FITYYDS/ne301/Script/docs/NE301_PRODUCT_CAPABILITY_OVERVIEW.md

# NE301 产品能力总图

## 1. 一句话理解

NE301 不是“一个能拍照的 AI 摄像头”这么简单，它本质上是一套把感知、联网、视频、AI、运维和升级能力，统一收敛到同一套 MCU 服务框架里的产品平台。

## 2. NE301 产品能力总图

```text
                                         +--------------------------------+
                                         |          NE301 产品能力        |
                                         +---------------+----------------+
                                                         |
                  +--------------------------------------+--------------------------------------+
                  |                                      |                                      |
                  v                                      v                                      v
       +------------------------+             +------------------------+             +------------------------+
       |     感知与触发域       |             |     连接与云协同域     |             |      视频与 AI 域      |
       +------------------------+             +------------------------+             +------------------------+
       | - 图片模式             |             | - WiFi / Cellular /    |             | - 本地实时预览         |
       | - 视频模式             |             |   PoE 多网络接入       |             | - WebSocket 视频输出   |
       | - PIR 触发             |             | - MQTT / MQTTS         |             | - RTMP / RTMPS 推流    |
       | - RTC 定时触发         |             | - 远程抓拍 / 远程休眠  |             | - 模型加载 / 重载      |
       | - 远程触发             |             | - 事件抓拍上报         |             | - 阈值调参             |
       | - 唤醒后快路径抓拍     |             | - 云端任务闭环         |             | - 单图验证 / 可视化    |
       +------------+-----------+             +------------+-----------+             +------------+-----------+
                    |                                      |                                      |
                    +----------------------+---------------+----------------------+---------------+
                                           |                                      |
                                           v                                      v
                              +------------+--------------------------------------+------------+
                              |                  设备与运维管理域                              |
                              +----------------------------------------------------------------+
                              | - 图像参数配置   - 灯光控制   - 存储管理   - 设备信息/设备名   |
                              | - 配置导入导出   - 日志导出   - 恢复出厂   - 系统重启          |
                              | - 固件版本查看   - 固件导出   - OTA 升级   - A/B 分区容错      |
                              +-------------------------------+--------------------------------+
                                                              |
                                                              v
                         +------------------------------------+------------------------------------+
                         |                     统一软件骨架                                  |
                         +-------------------------------------------------------------------+
                         | API 适配层: api_work_mode / api_network / api_mqtt / api_rtmp    |
                         |            api_ai / api_device / api_ota / api_preview            |
                         | Service 层: system_service / communication_service / mqtt_service  |
                         |            rtmp_service / ai_service / device_service / ota_service|
                         | Shared   : json_config_mgr / video_hub / service_init / NVS        |
                         +------------------------------------+--------------------------------+
                                                              |
              +-----------------------------------------------+-----------------------------------------------+
              |                                               |                                               |
              v                                               v                                               v
   +---------------------------+                  +---------------------------+                  +---------------------------+
   |       执行与驱动底座      |                  |       数据与存储底座      |                  |      整机架构底座         |
   +---------------------------+                  +---------------------------+                  +---------------------------+
   | - Camera / Encoder / AI   |                  | - Flash / OTA slots       |                  | - STM32N6 主控           |
   | - WiFi / 4G / PoE         |                  | - SD card / config        |                  | - U0 WakeCore            |
   | - Sensor / PIR / Light    |                  | - system_state / version  |                  | - 双 MCU 低功耗协同      |
   | - lwIP / Mongoose / HAL   |                  | - model package           |                  | - Web UI 本地管理入口    |
   +---------------------------+                  +---------------------------+                  +---------------------------+
```

## 3. 这张图怎么读

从上往下看：

1. 最上面是用户真正能感知到的产品能力。
2. 中间是这些能力共用的统一软件骨架，也就是 `api_xxx -> service_xxx -> config/persist -> HAL`。
3. 最下面是支撑这些能力的底座，包括视频链路、网络链路、存储链路，以及 `U0 + N6` 的双 MCU 架构。

从左往右看：

1. 左边偏“触发与控制”。
2. 中间偏“联网与云协同”。
3. 右边偏“视频与 AI 数据面”。
4. 下方单独汇总“设备运维与升级”。

## 4. 这张总图对应的核心判断

- NE301 的很多功能虽然在 wiki 上看起来是分散菜单，但在软件上并不是很多孤立模块，而是同一套服务框架的不同投影。
- `system_service` 是控制面中枢，`communication_service` 是网络中枢，`video_hub` 是视频数据分发中枢。
- 产品功能的扩展方式不是继续堆页面，而是往现有服务框架里接入新的策略、事件源和消费者。
