FITYYDS/ne301/Web/src/assets/images/camthink_Vision_AI_camera.webp

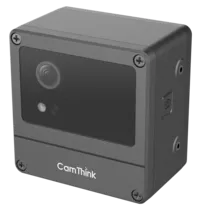
Web/src/assets/images/camthink_Vision_AI_camera.webp
