FITYYDS/ne301/Hardware/x3_top_cover.stp

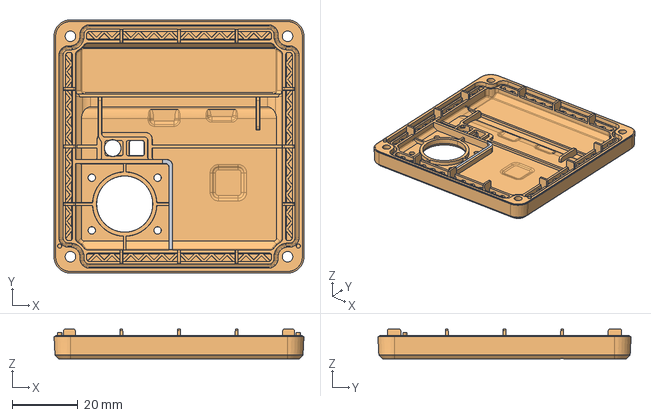
[picture p2: CAD file, 2026-01-15]
Hardware/x3_top_cover.stp
76.0 x 77.0 x 9.10 mm
