FITYYDS/ne301/Hardware/x3_d_cover.stp

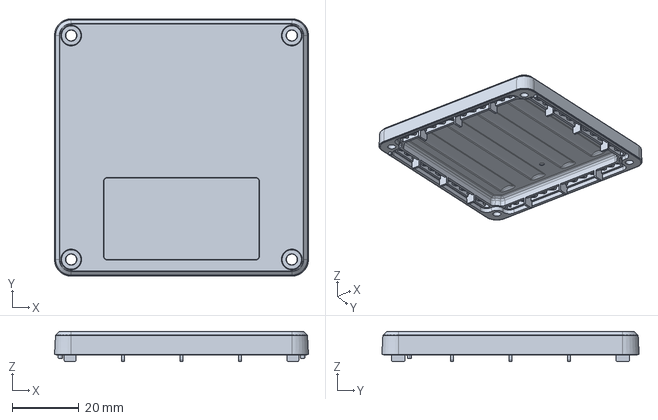
[picture p3: CAD file, 2026-01-15]
Hardware/x3_d_cover.stp
76.0 x 77.0 x 9.10 mm
