FITYYDS/ne301/Hardware/NE301_PCB.pdf

# ART FILM - SILKTOP

2025-10-21

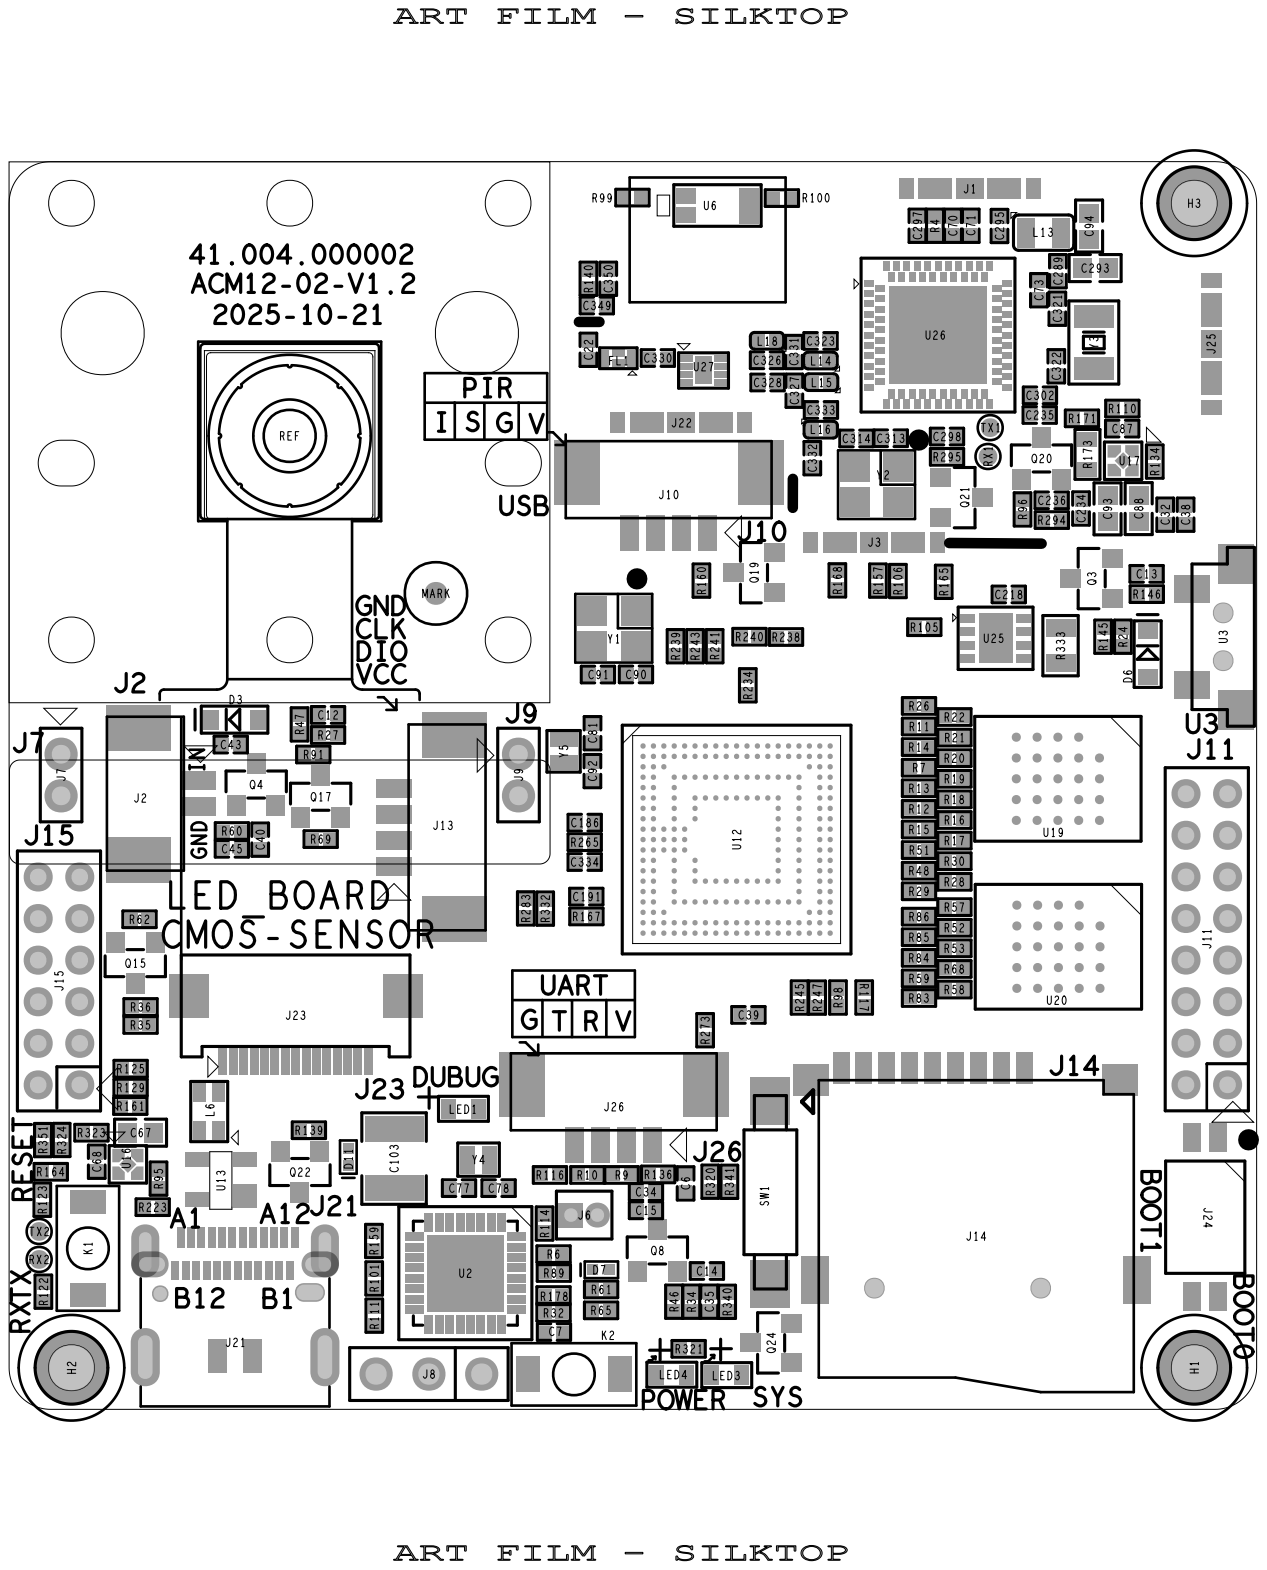
[picture p4: page 1]

R125 | J26
R129 R161 | | LED1

J8 | C7 | R321 LED4 LED3

# ART FILM - SILKBOT

# C239 R104 C69

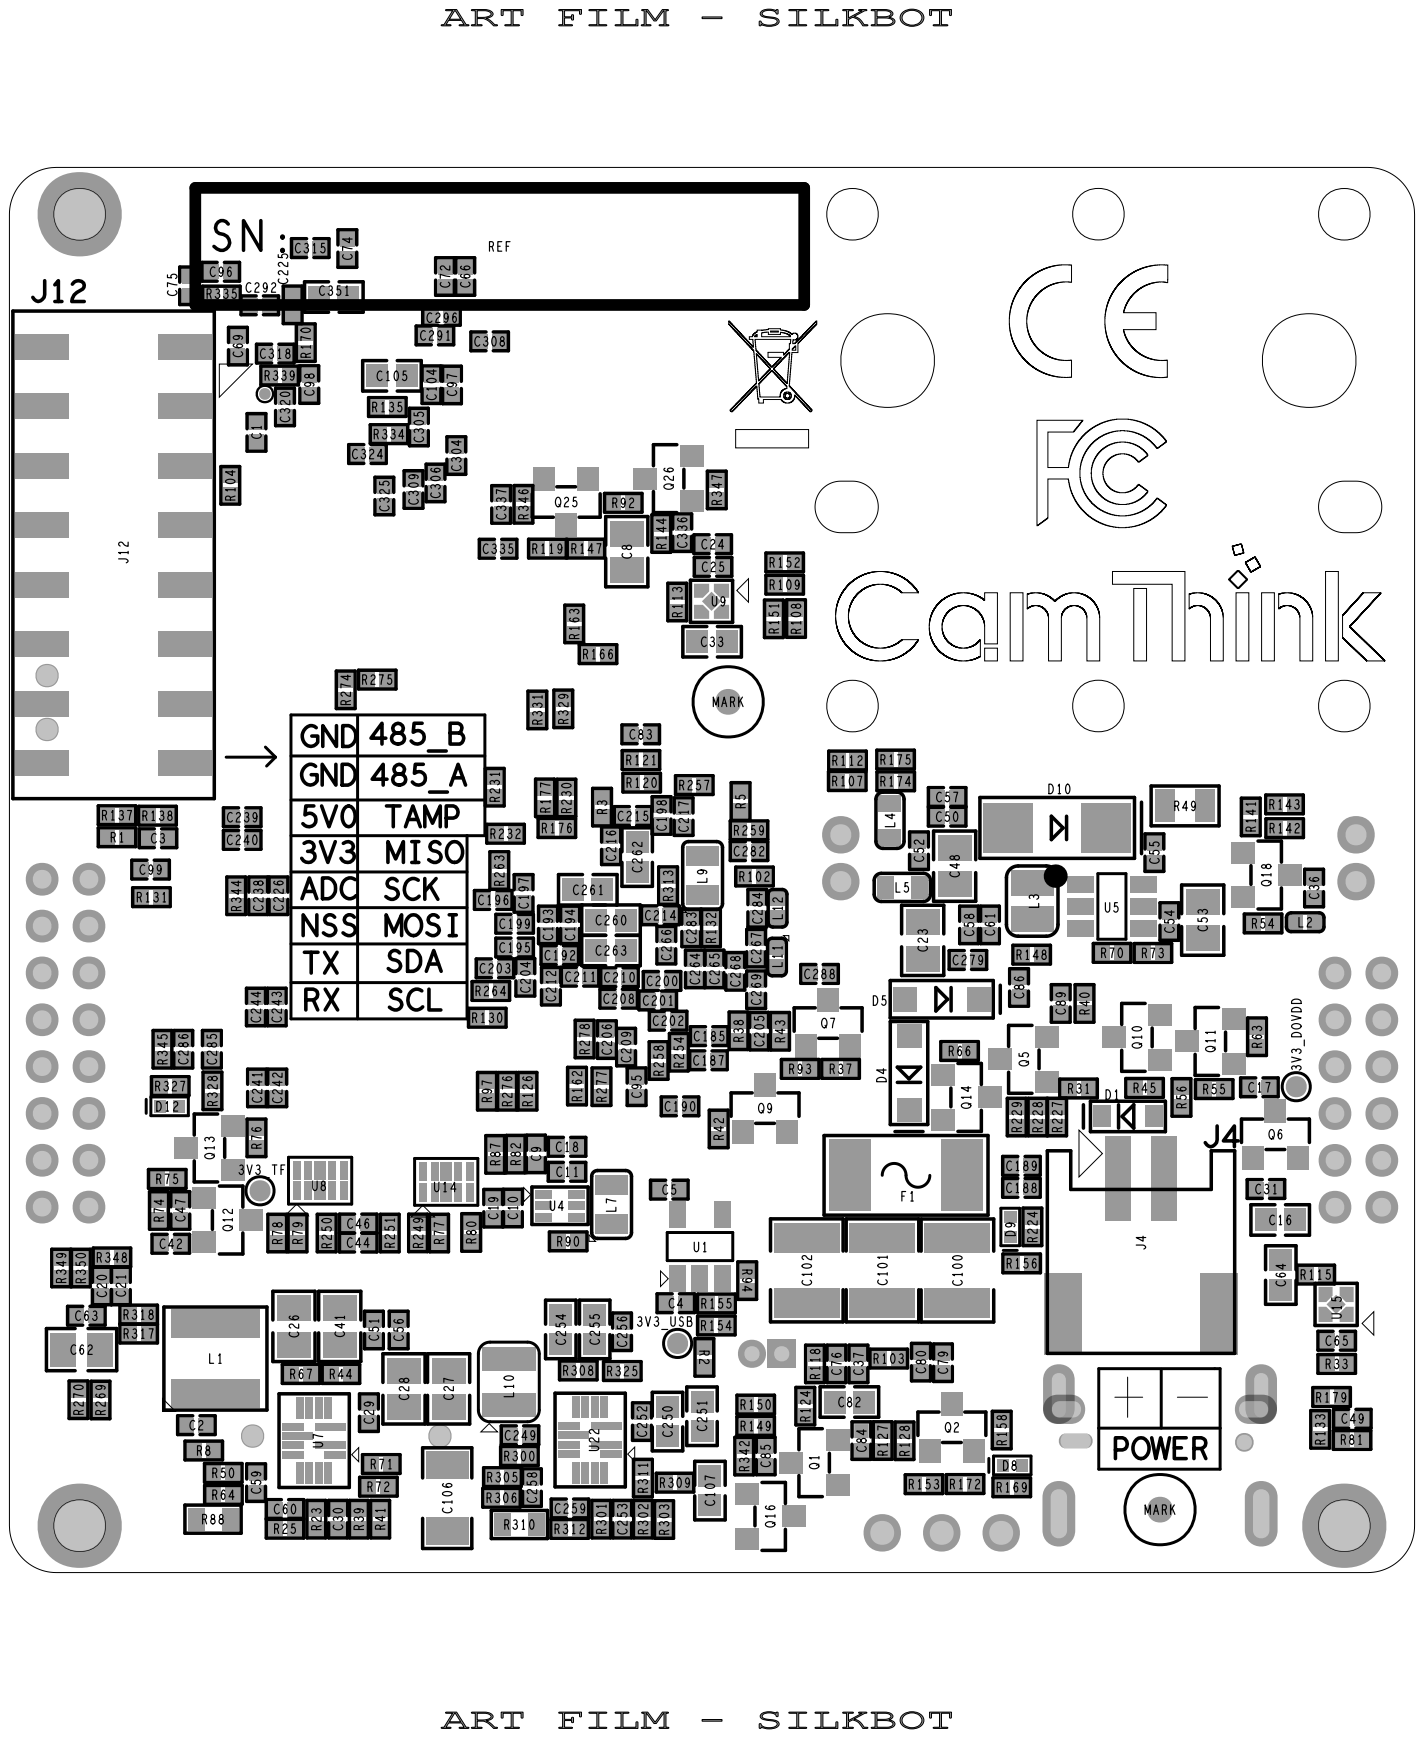
[picture p5: page 2]

5V0 3V3 | TAMP MISO | R232 R259 C282

NSS | MOSI
TX | SDA
