FITYYDS/ne301/Hardware/NE301_Schematic.pdf

D | D

# BLOCK DIAGRAM

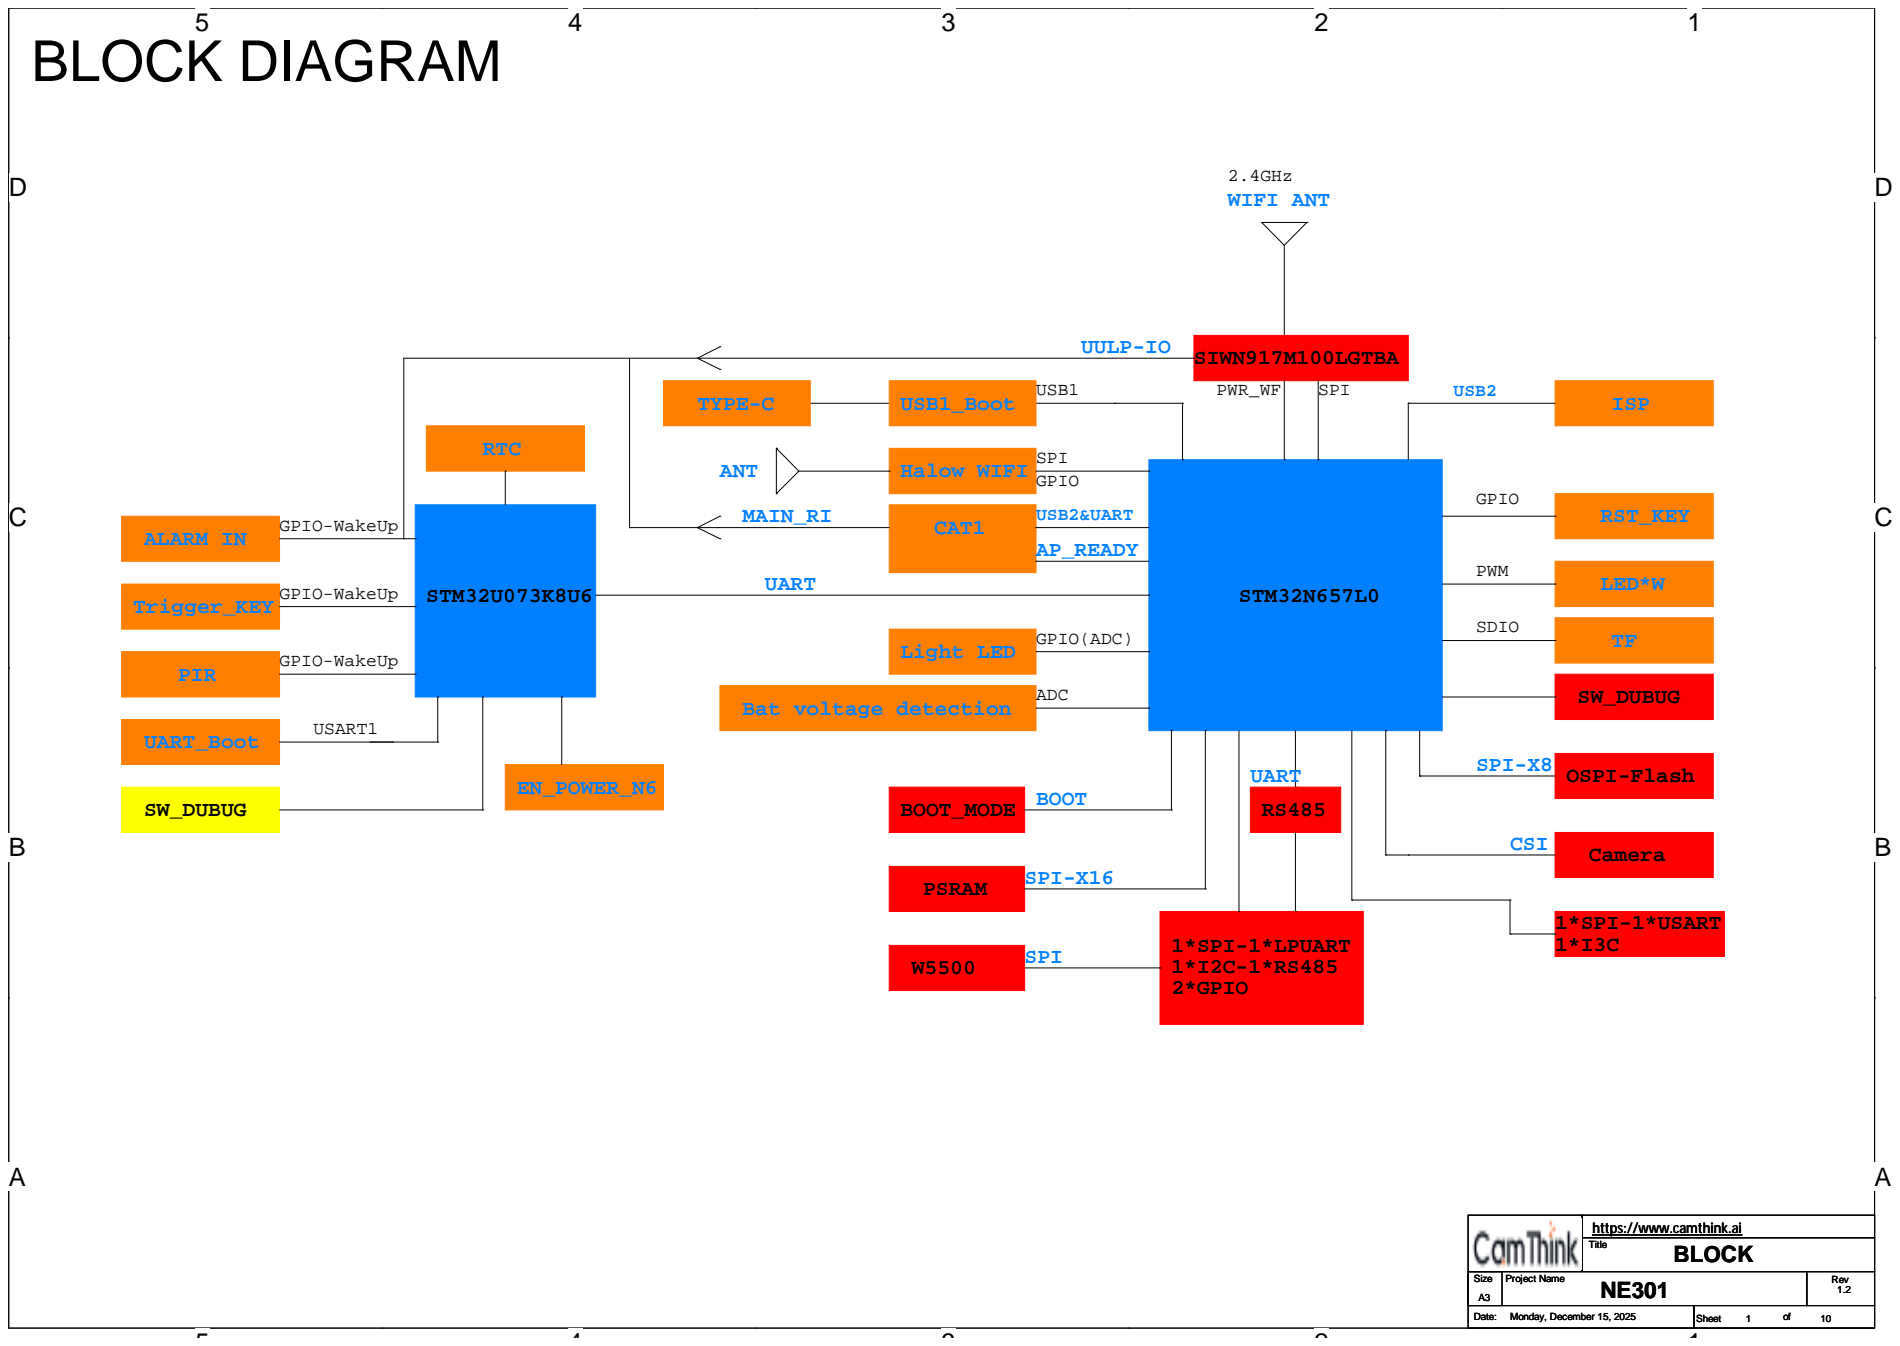
[picture p6: page 1]
Halow WIFI; ADC; TYPE-C; CAT1; 2.4GHz; GPIO(ADC); RST_KEY; GPIO; USB1_Boot; USB1; SW_DUBUG; WIFI ANT; ANT; STM32N657L0; SPI; USB2&UART; Light LED; PWM; LED*W; PSRAM; SPI-X16; Camera CSI; SDIO; PWR_WF; SIWN917M100LGTBA; ISP; USB2; 1*SPI-1*LPUART 1*I2C-1*RS485 2*GPIO; UART; BOOT_MODE; 1*SPI-1*USART 1*I3C; BOOT; STM32U073K8U6; GPIO-WakeUp; ALARM IN; Trigger_KEY; PIR; UART_Boot; USART1; RTC; UULP-IO; MAIN_RI; AP_READY; EN_POWER_N6; Size Project Name; Rev; Date:; Sheet; BLOCK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

Bat voltage detection

OSPI-Flash SPI-X8

https://www.camthink.ai
Title

# POWER TREE

## MP1462GD-Z

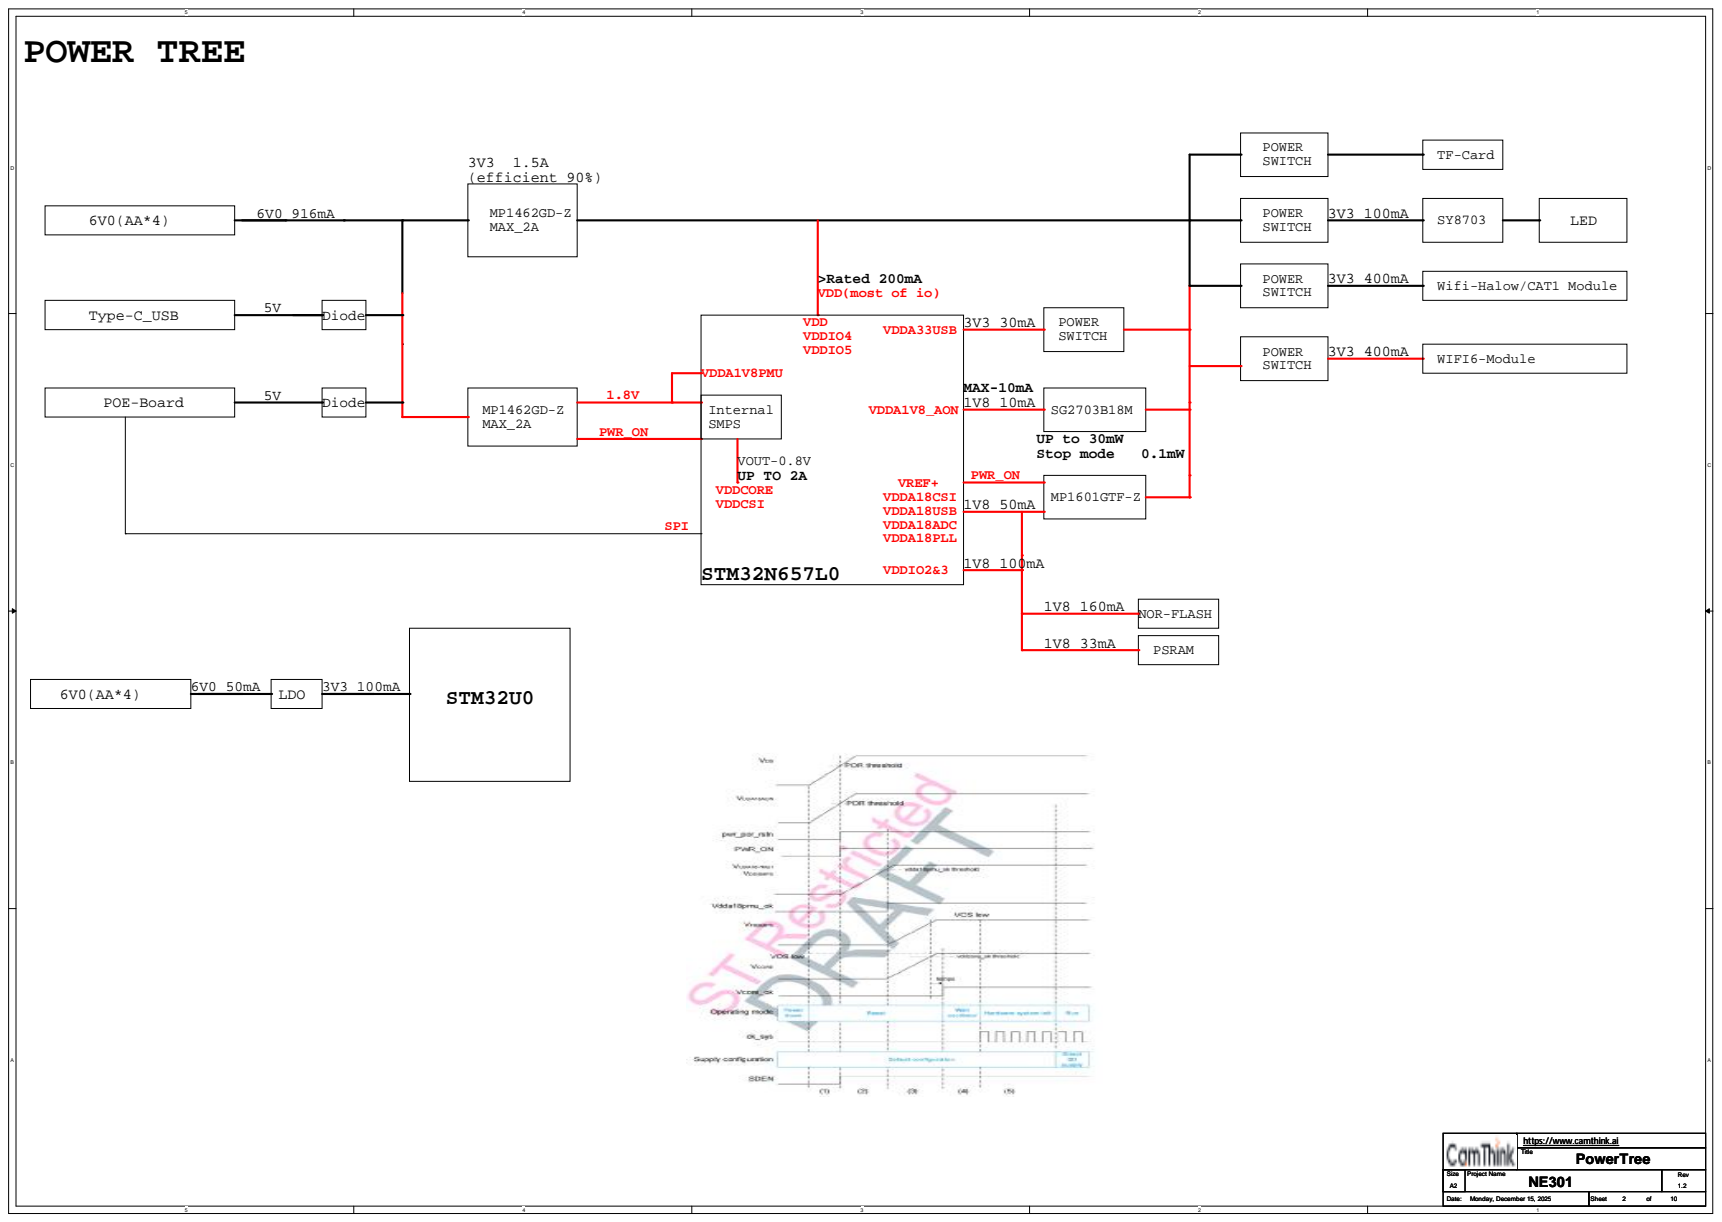
[picture p7: page 2]
MAX_2A 6V0(AA*4); 3V3 1.5A (efficient 90%); POWER SWITCH; LED 3V3 100mA; Type-C_USB; VDDA1V8_AON; STM32N657L0; VDDA33USB; VDDA18CSI VDDA18USB VDDA18ADC VDDA18PLL; VDD VDDIO4 VDDIO5; VREF+; PWR_ON; VDDCORE VDDCSI; POWER; SWITCH; TF-Card; WIFI6-Module; MAX-10mA; Stop mode; MP1462GD-Z MAX_2A; Internal SMPS; VOUT-0.8V; NOR-FLASH; PSRAM; POE-Board; SPI; VDDA1V8PMU; Diode; MP1601GTF-Z; VDDIO2&3 1V8 100mA; STM32U0 ⁶V0 50mA LDO 3V3 100mA; Title; PowerTree; Monday, December 15, 2025

>Rated 200mA
VDD(most of io)

Wifi-Halow/CAT1 Module 3V3 400mA

https://www.camthink.ai

# STM32N6

## STM32N657L0H3Q

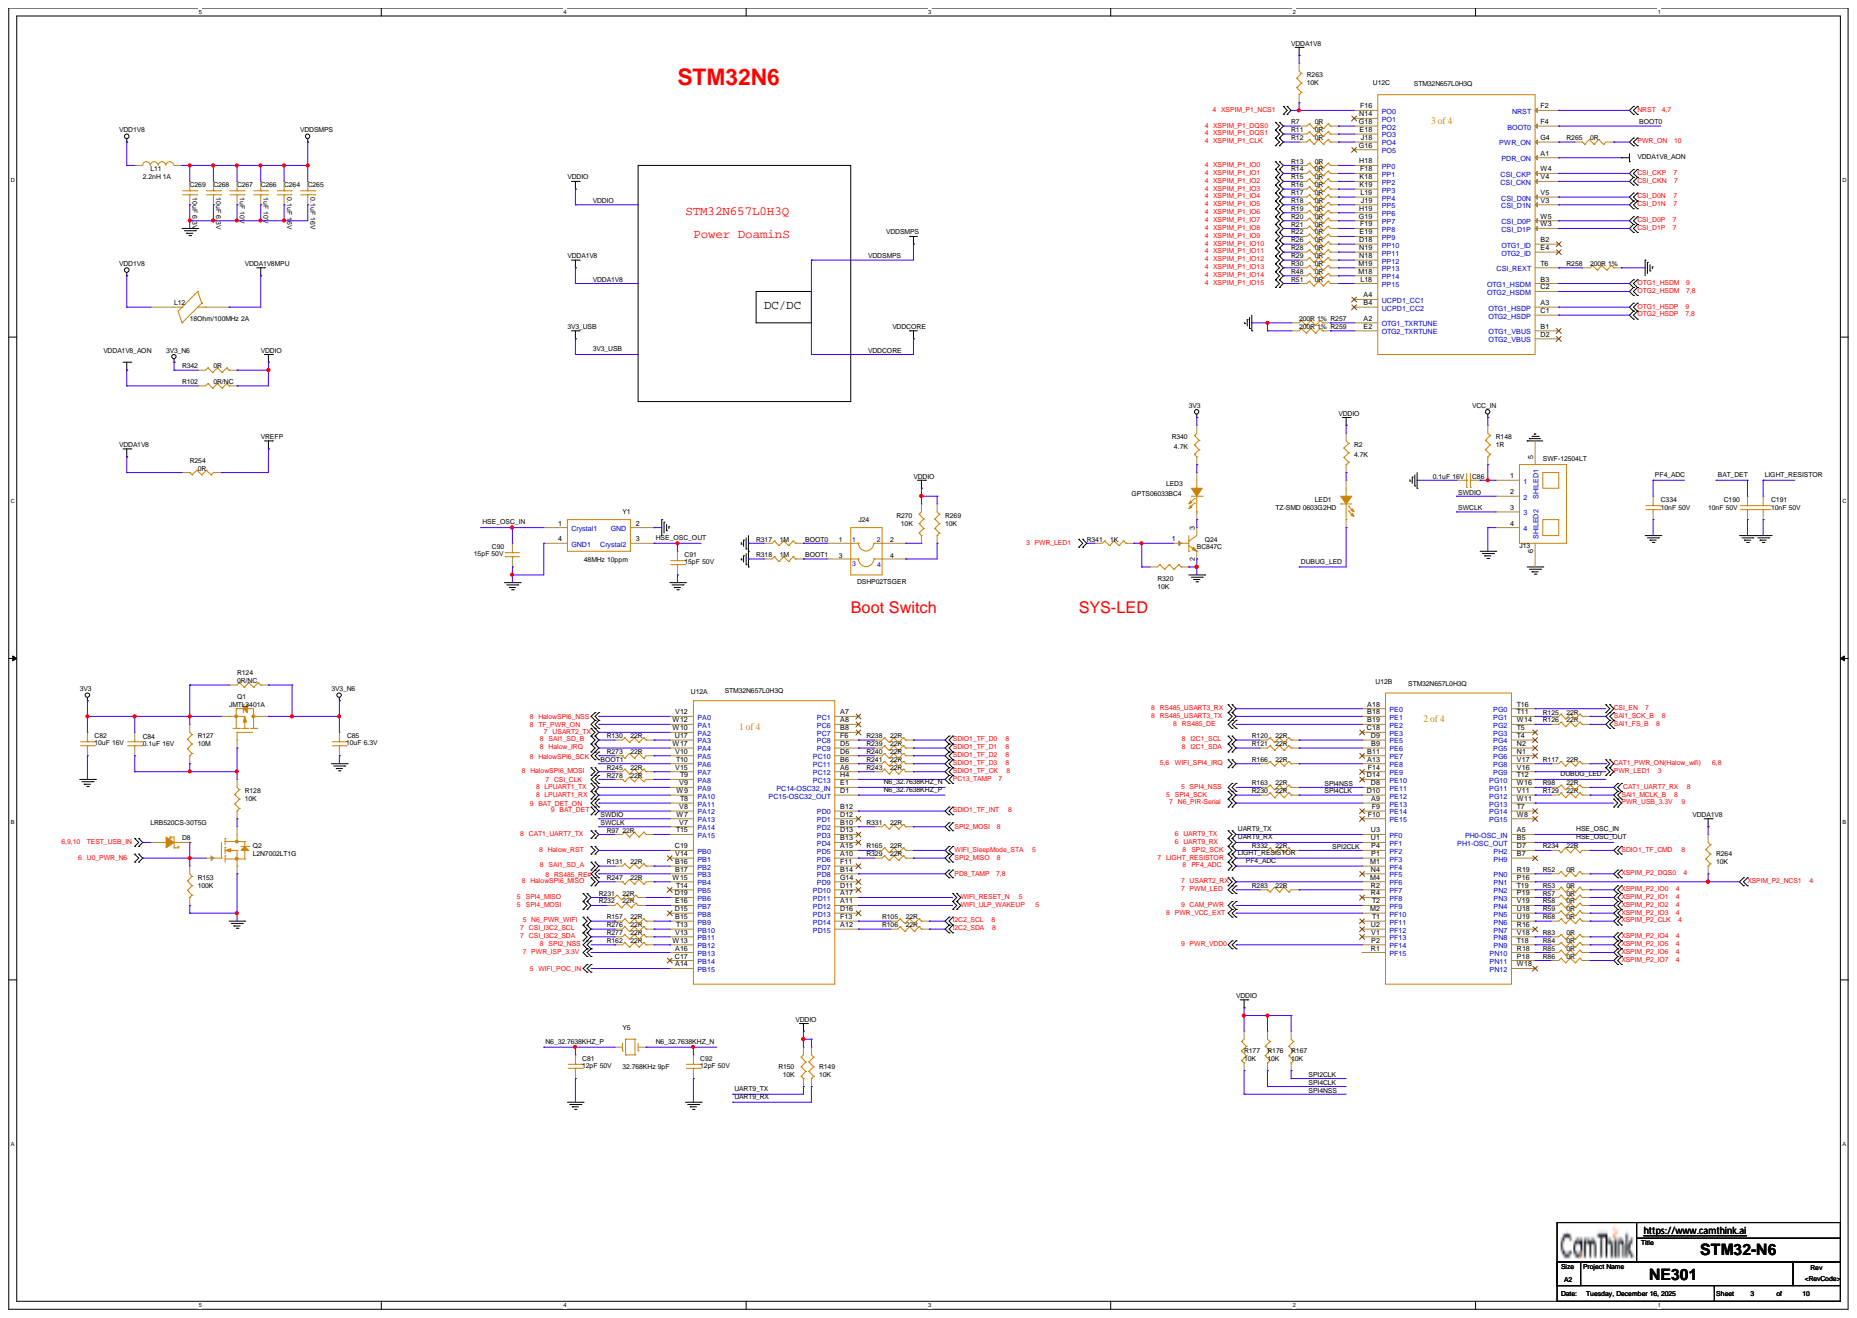
[picture p8: page 3]

https://www.camthink.ai

# PSRAM

## VDD_PSRAM

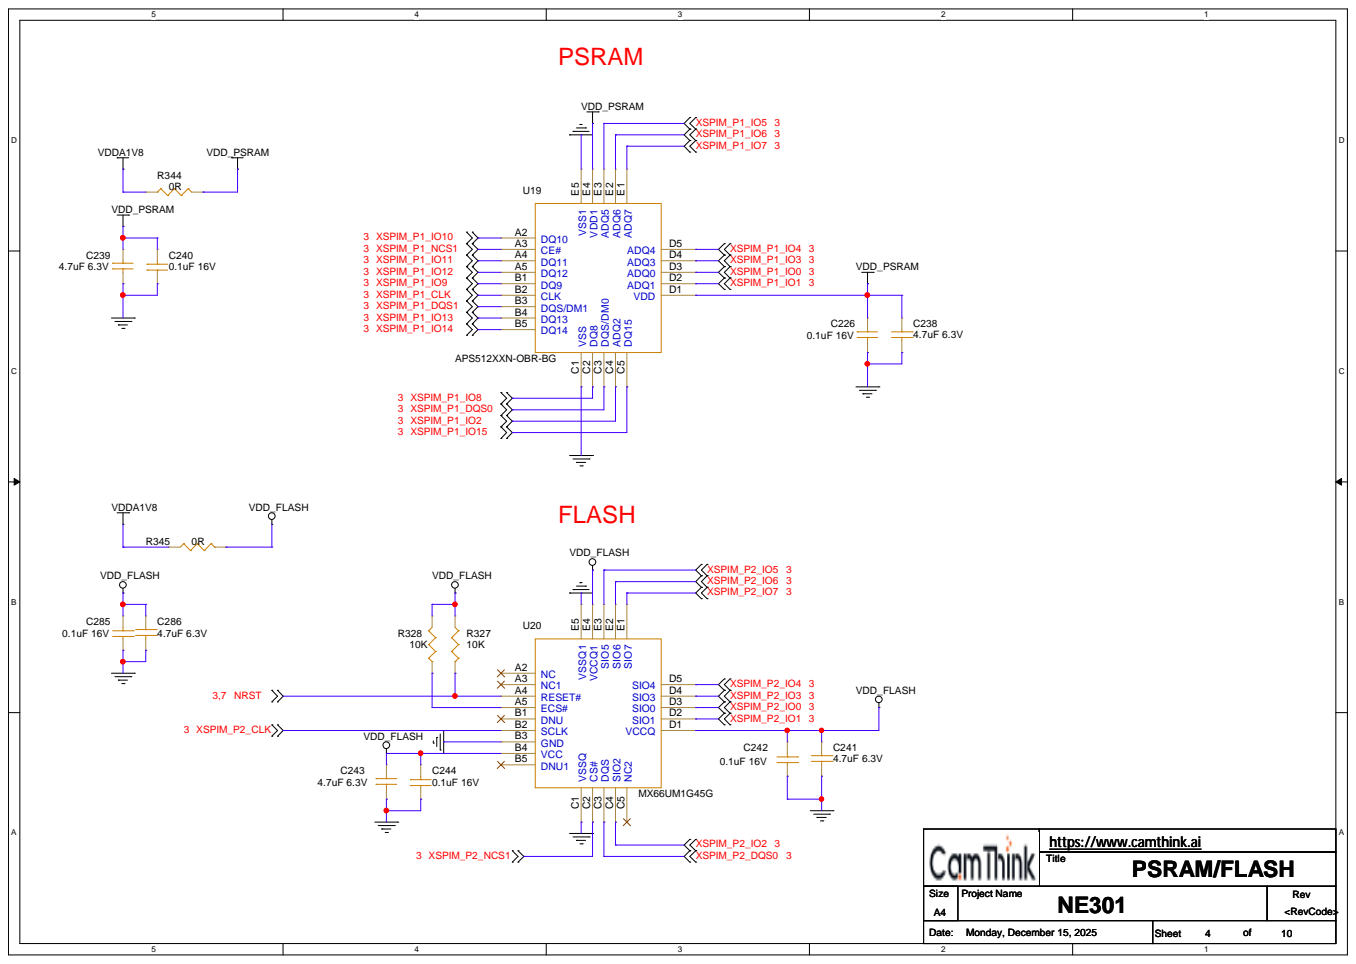
[picture p9: page 4]

## Power-IN

## 3V3_WIFI

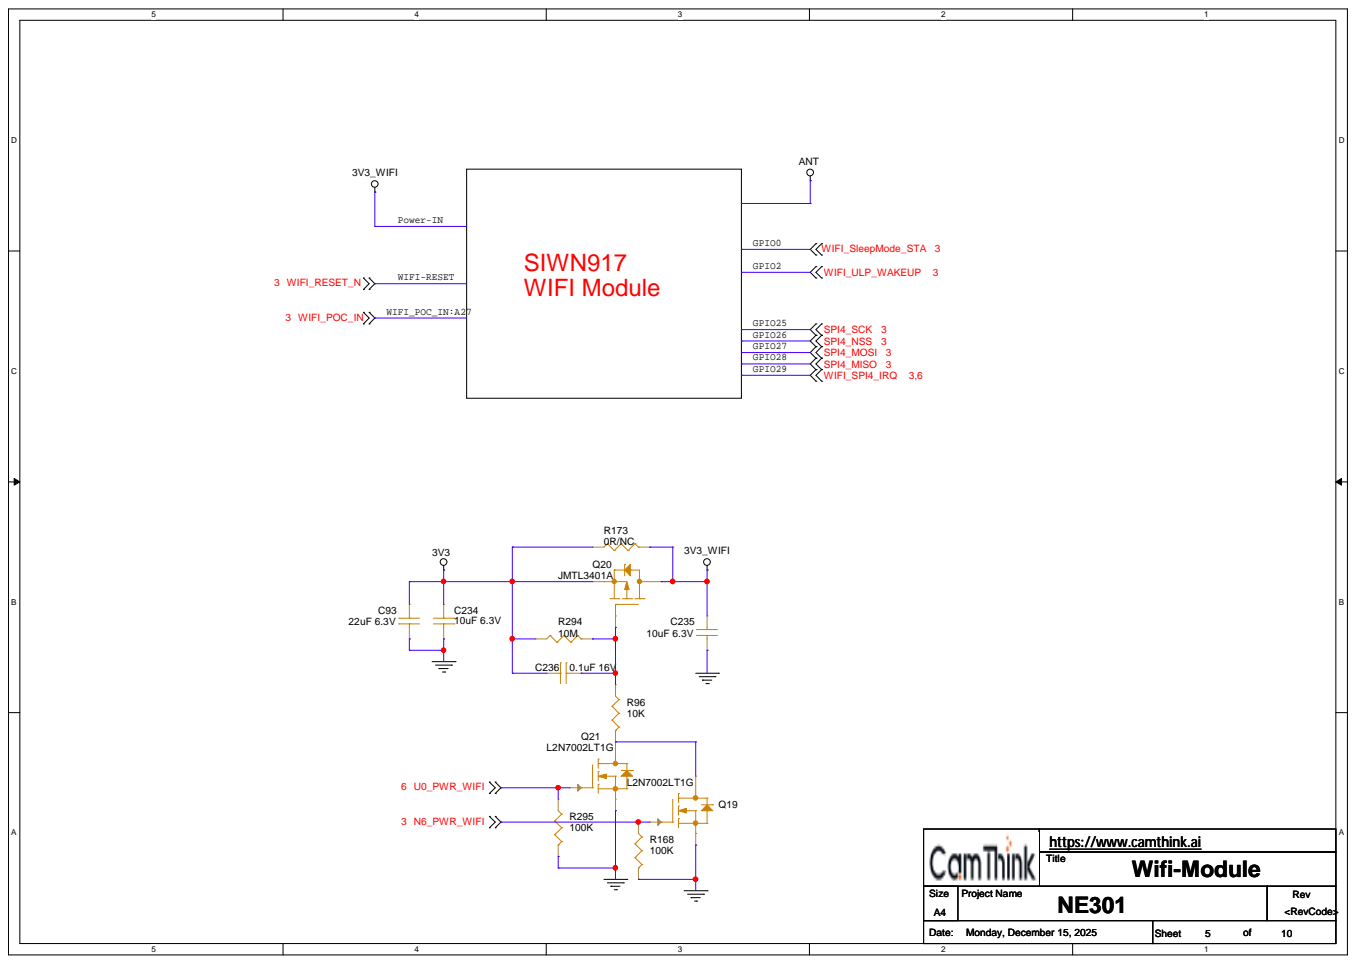
[picture p10: page 5]

https://www.camthink.ai

## 3V3_U0

## VCC_IN

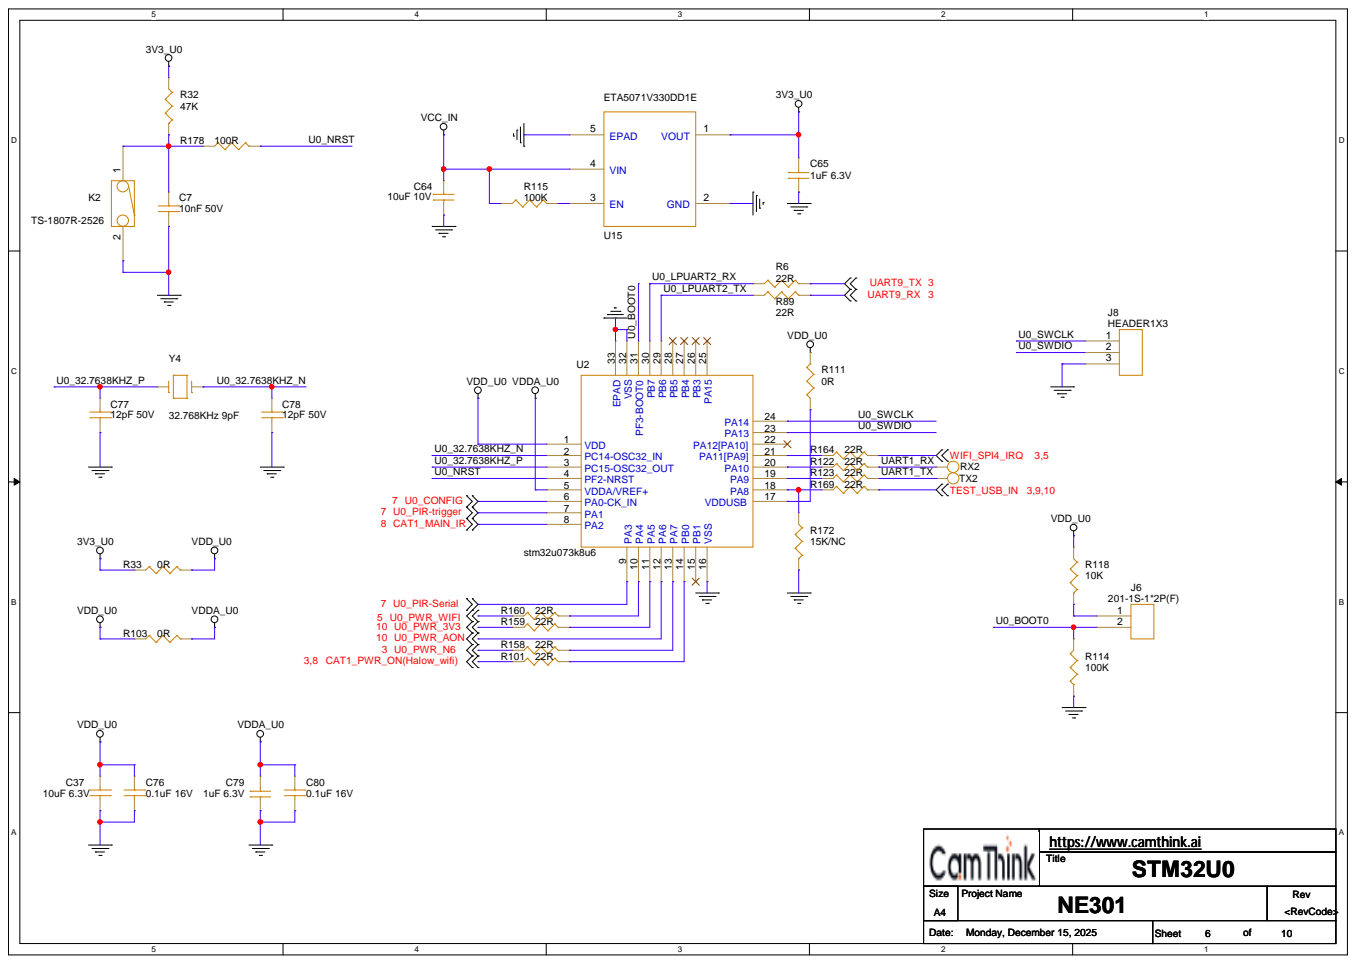
[picture p11: page 6]

D | D

# Photo-Diode detect

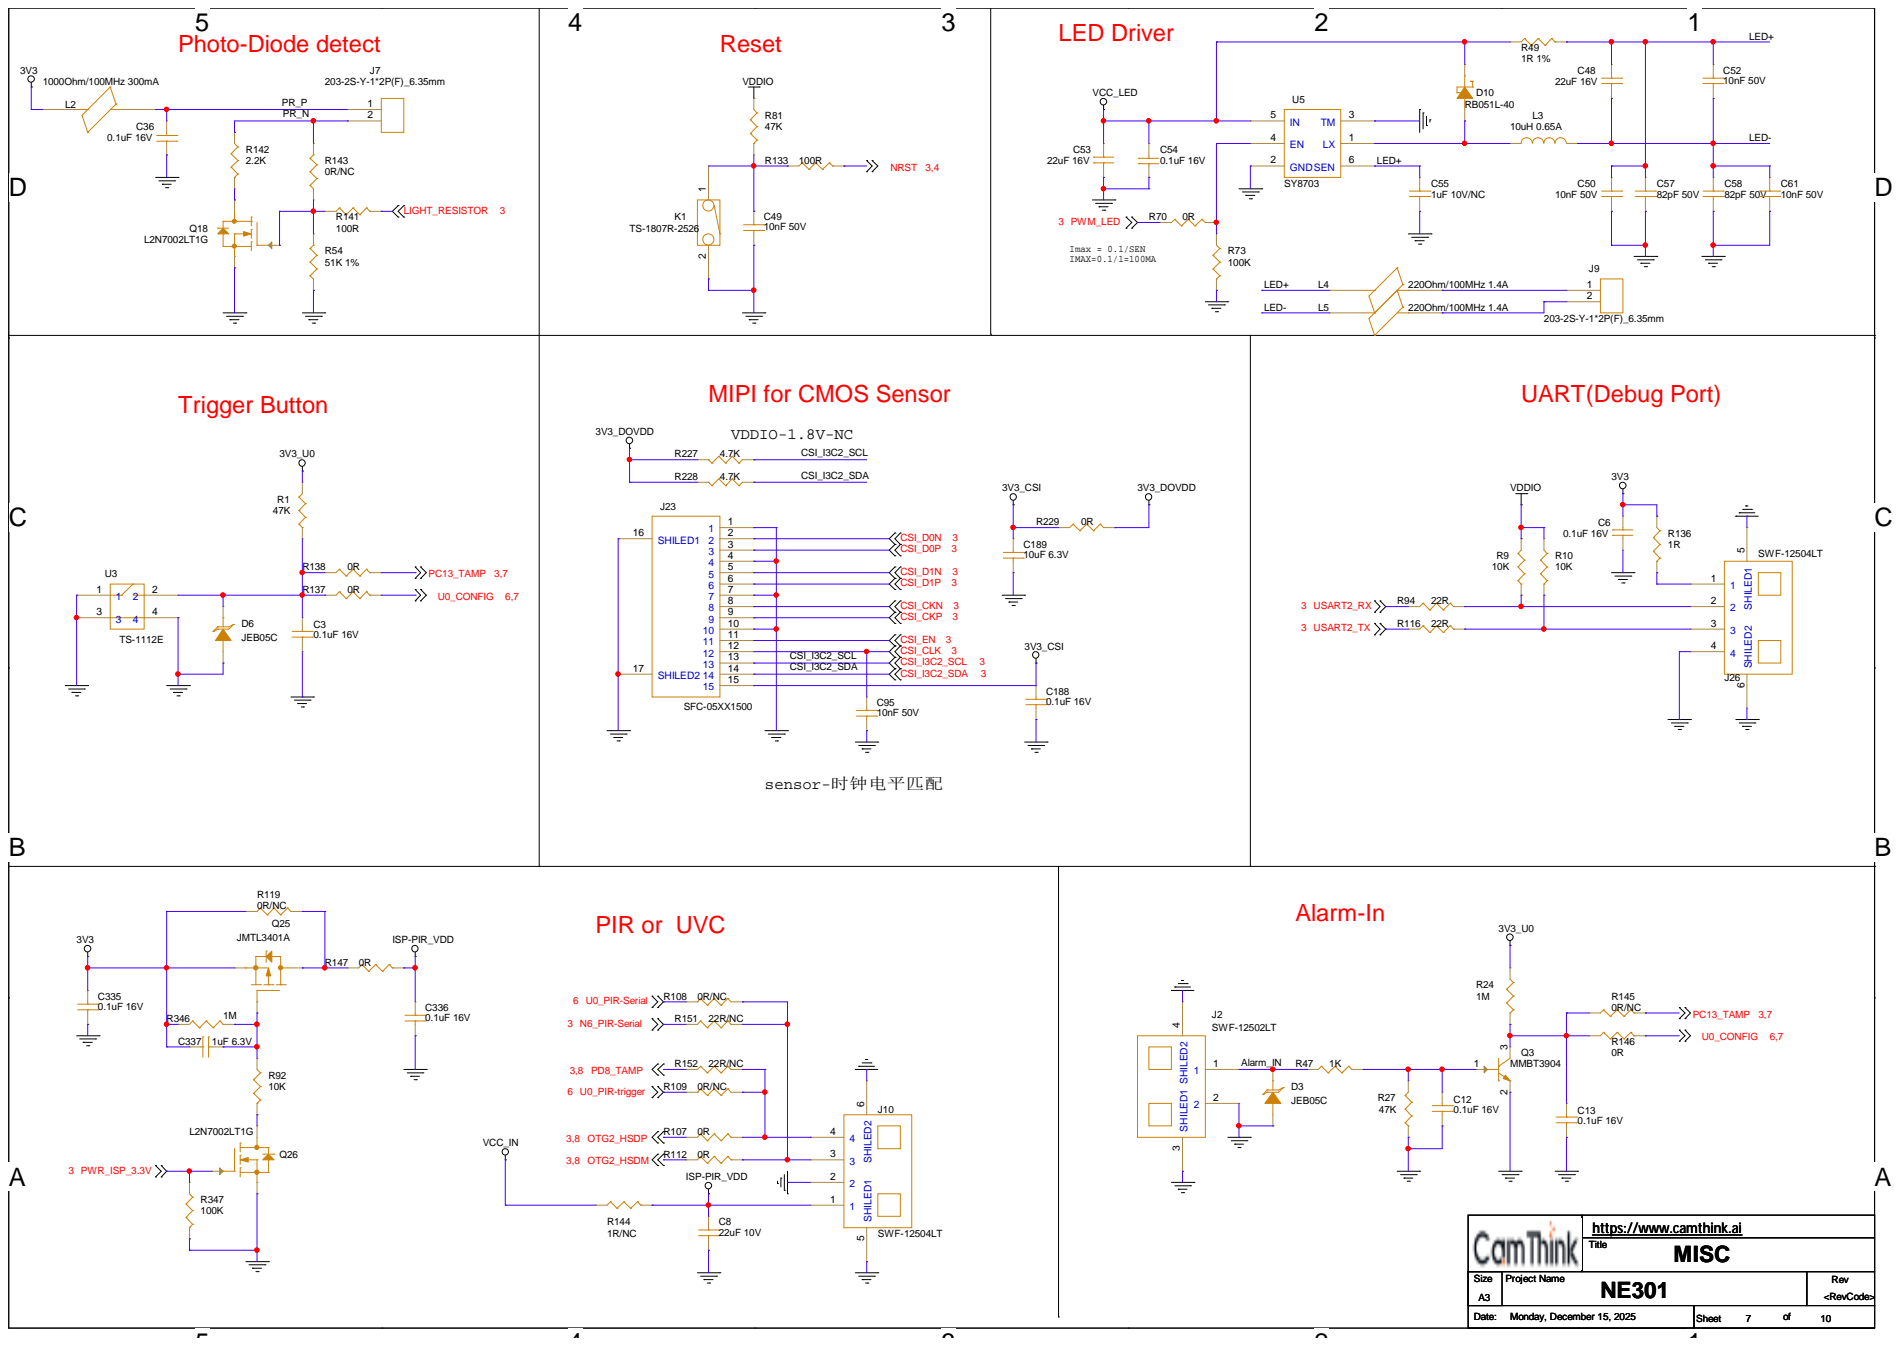
[picture p12: page 7]

3V3 VDDIO

https://www.camthink.ai
Title

D | D

# IOs for Communication Module

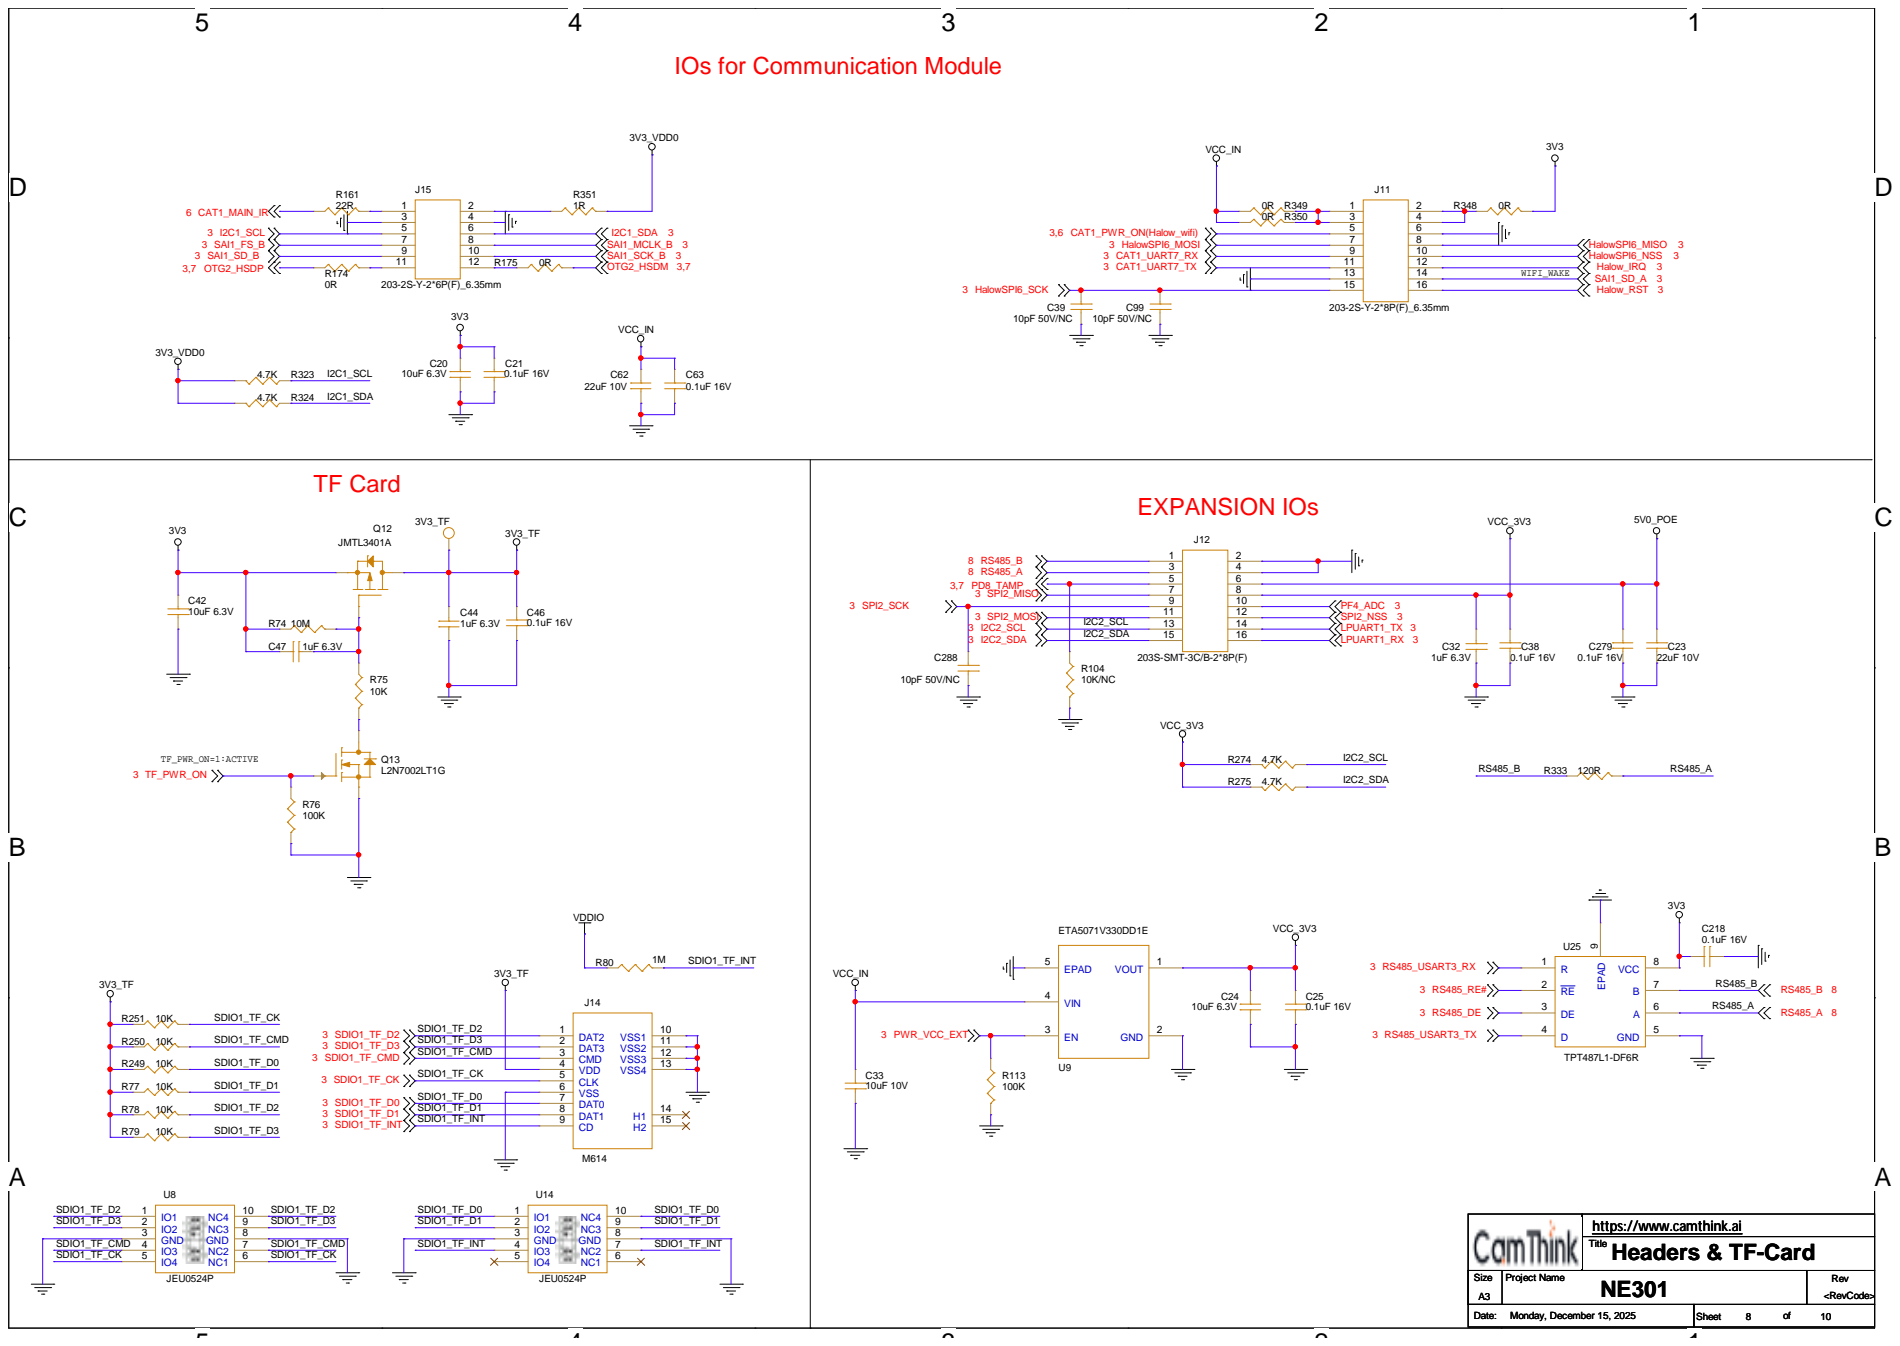
[picture p13: page 8]

https://www.camthink.ai
Title
Headers & TF-Card

D | D
Power IN | USB (TYPE-C)

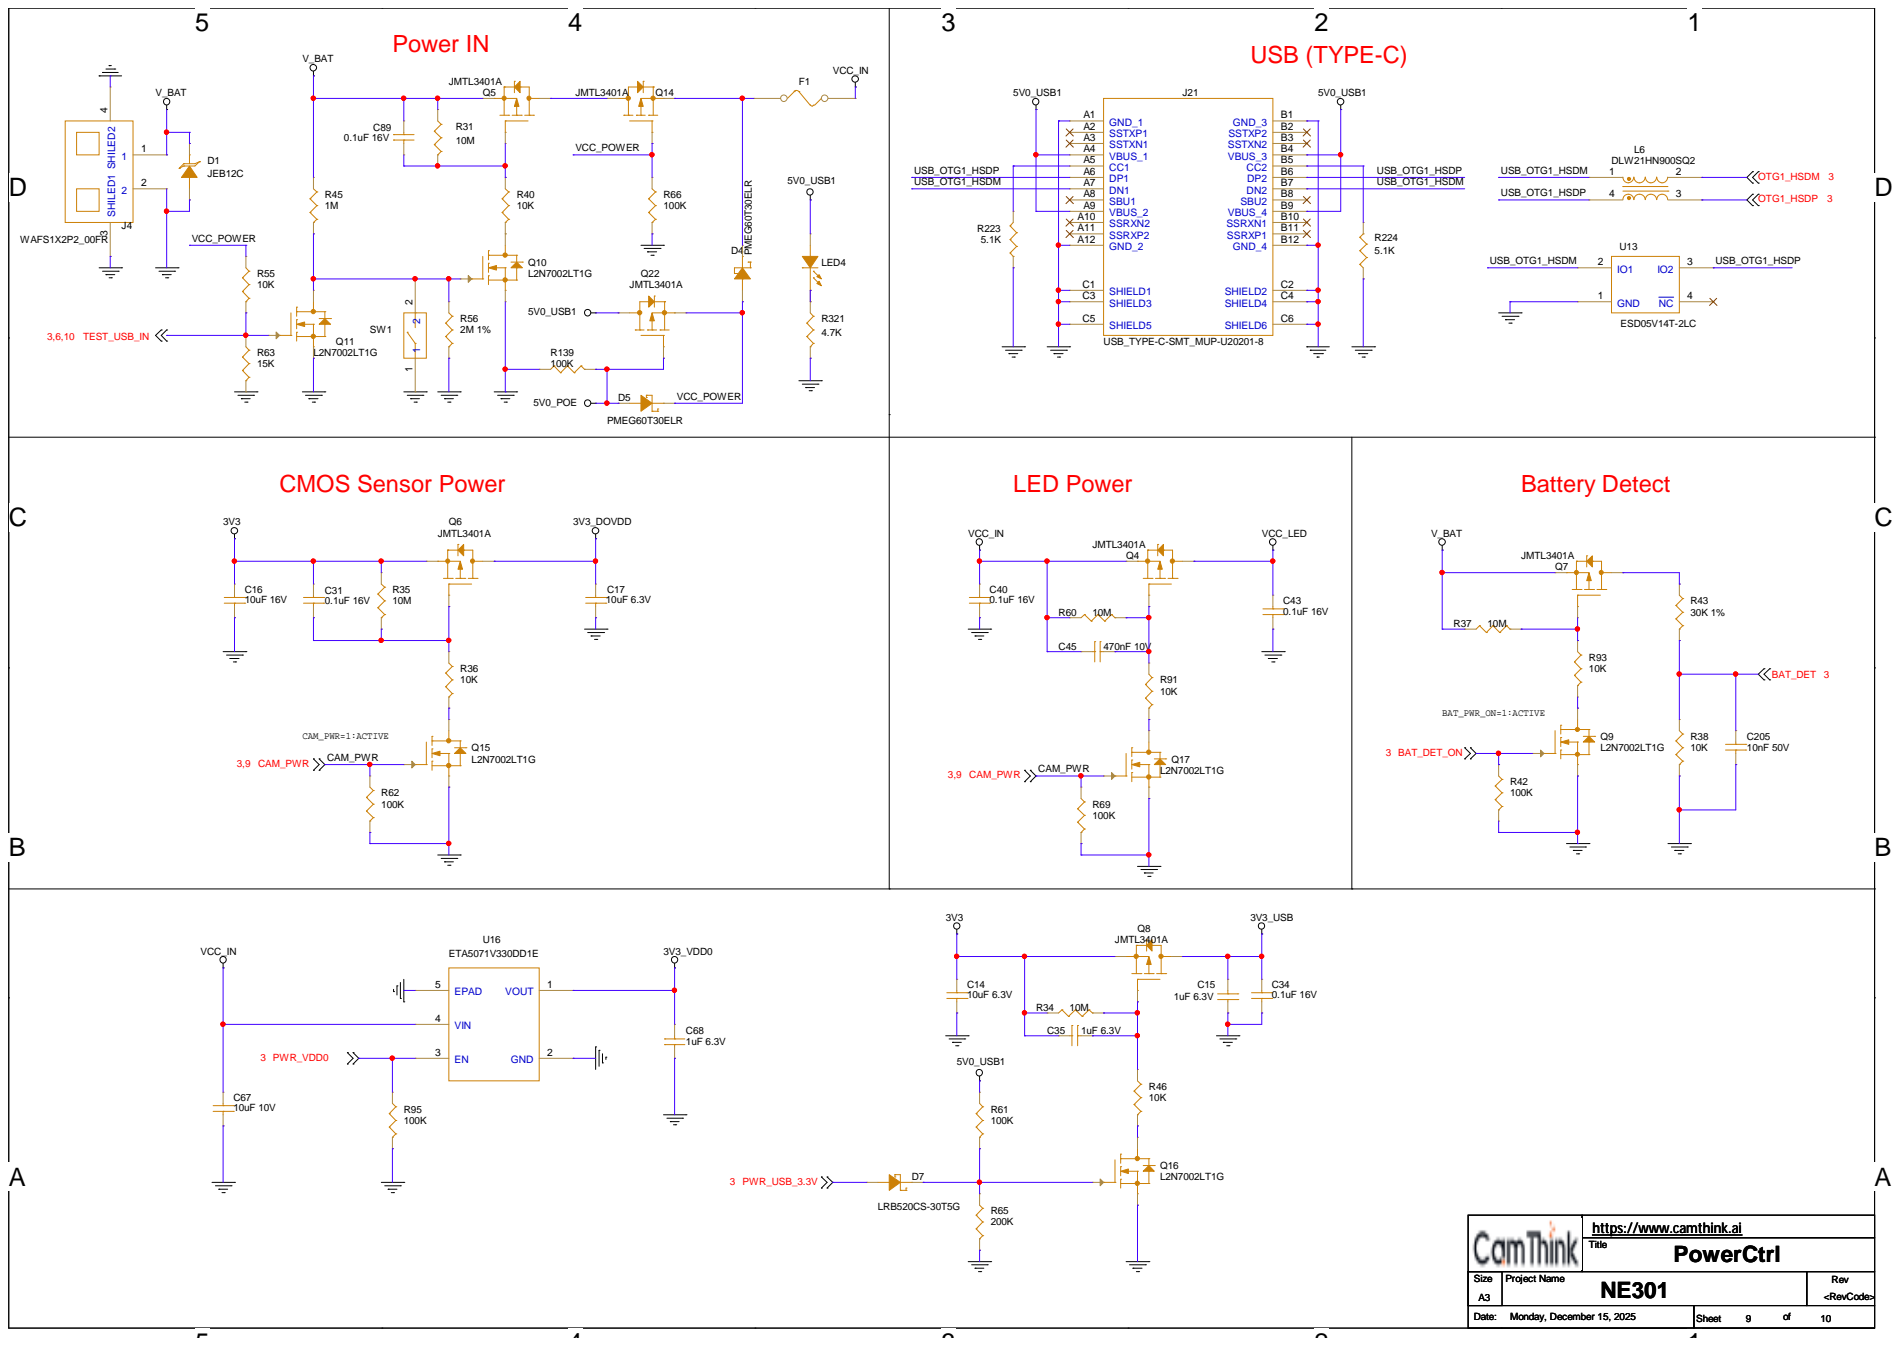
[picture p14: page 9]

https://www.camthink.ai
Title

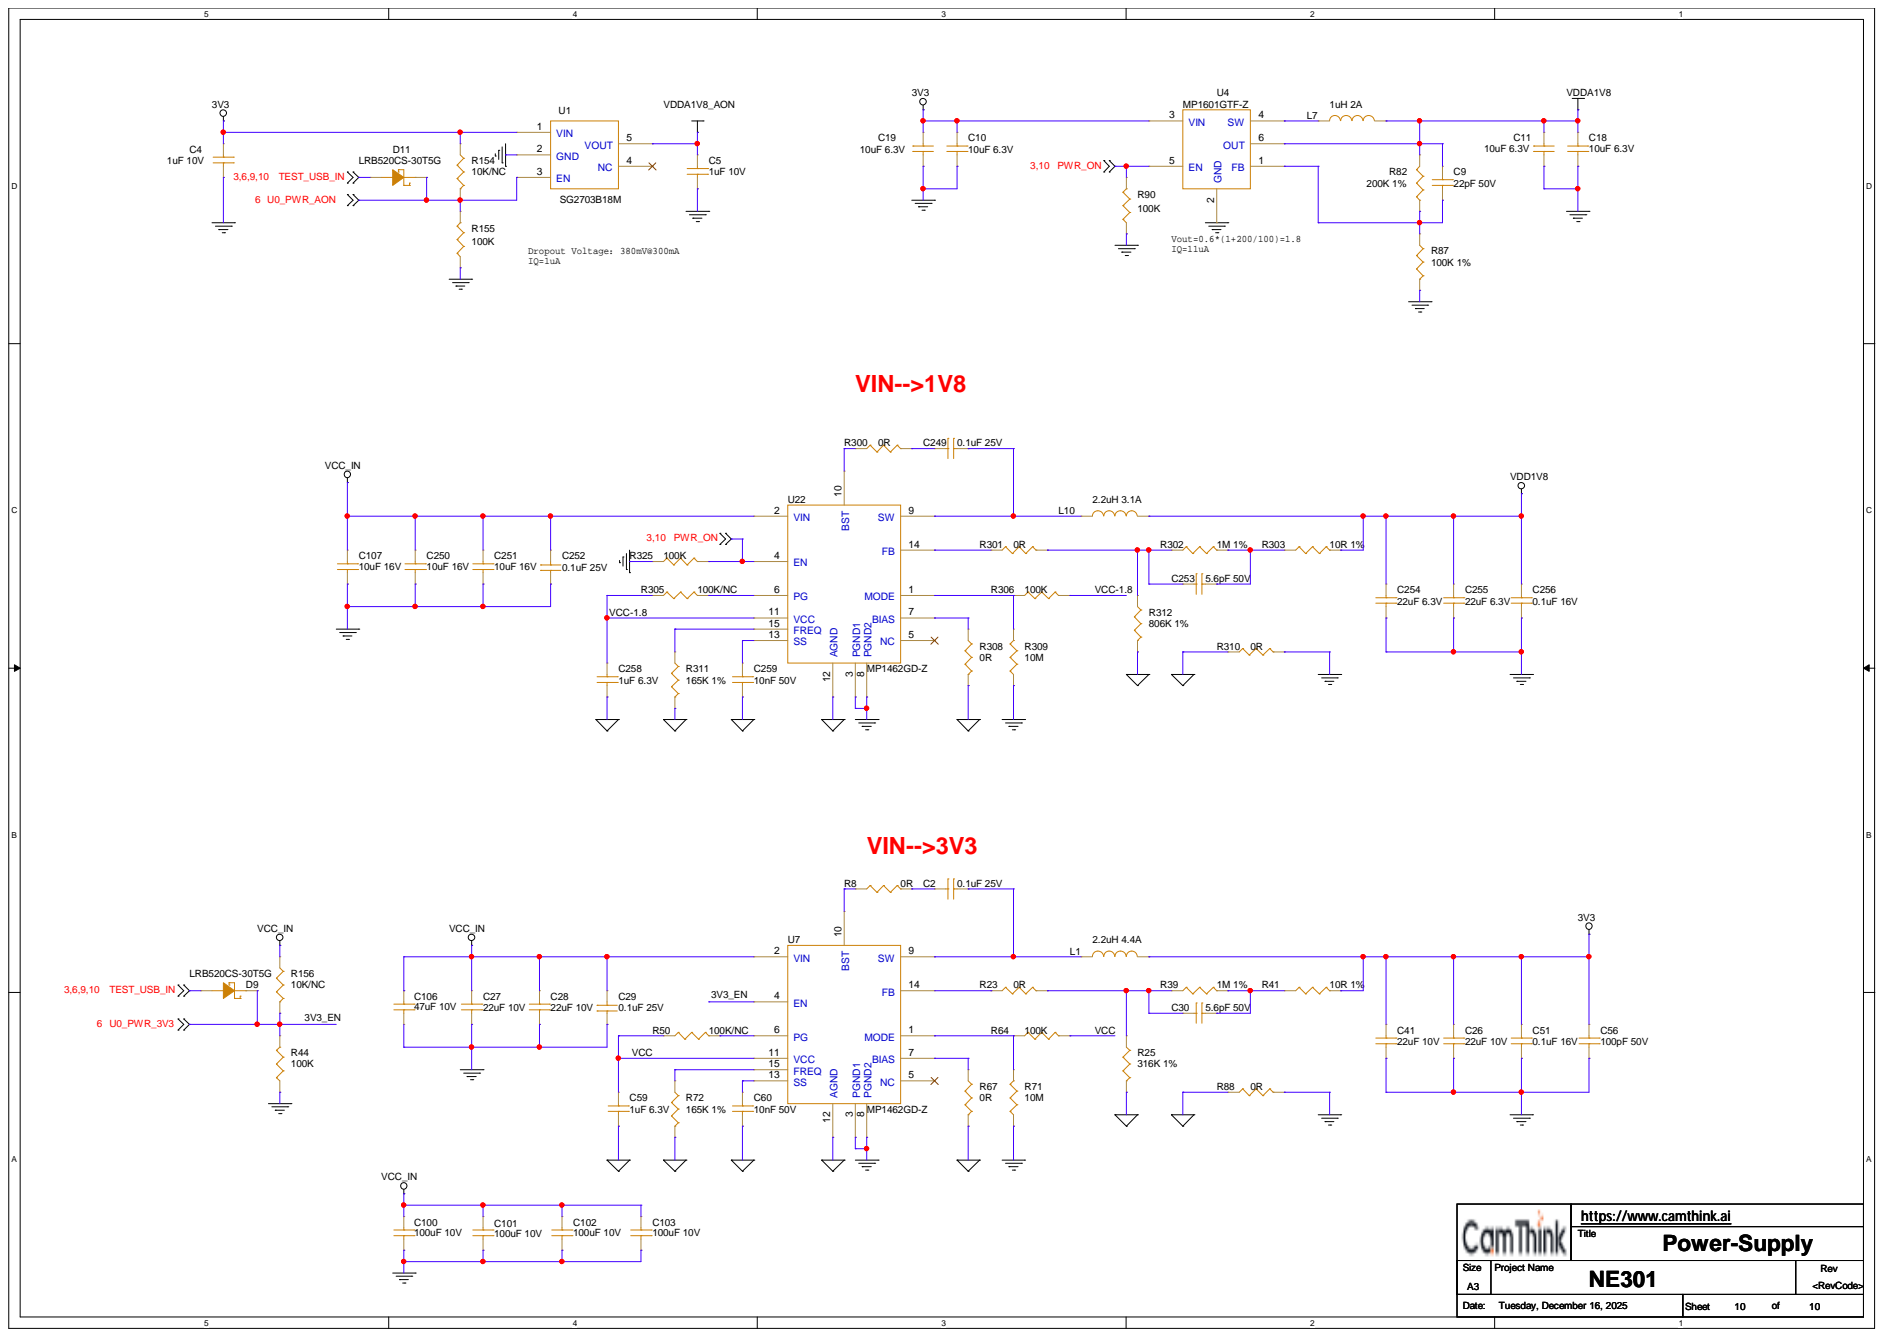
[picture p15: page 10]

https://www.camthink.ai
Title
