FITYYDS/ne301/WakeCore/Core/Src/main.c

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
/* Includes ------------------------------------------------------------------*/
#include "main.h"
#include "cmsis_os2.h"
#include "crc.h"
#include "dma.h"
#include "iwdg.h"
#include "usart.h"
#include "rtc.h"
#include "spi.h"
#include "gpio.h"

/* USER CODE BEGIN Includes */
#include <stdio.h>
/* USER CODE END Includes */

/* USER CODE BEGIN PD */
#ifdef __GNUC__
#define PUTCHAR_PROTOTYPE int __io_putchar(int ch)
#else
#define PUTCHAR_PROTOTYPE int fputc(int ch, FILE *f)
#endif
PUTCHAR_PROTOTYPE
{
	HAL_UART_Transmit(&huart1, (uint8_t *)&ch, 1, 10);
	return ch;
}
/* USER CODE END PD */


void SystemClock_Config(void);
void MX_FREERTOS_Init(void);
/* USER CODE BEGIN 0 */
void Flash_OPT_Check(void)
{
  uint8_t wflag = 0;
  FLASH_OBProgramInitTypeDef obConfig = {0};

  // printf("Flash OPT Check...\r\n");
  HAL_FLASH_Unlock();
  HAL_FLASH_OB_Unlock();

  HAL_FLASHEx_OBGetConfig(&obConfig);
  // Check if IWDG is disabled in STOP and STDBY modes
  if (obConfig.USERConfig & FLASH_OPTR_IWDG_STDBY) {
    printf("IWDG_STDBY enable\r\n");
    obConfig.USERConfig &= ~FLASH_OPTR_IWDG_STDBY;
    wflag = 1;
  }
  if (obConfig.USERConfig & FLASH_OPTR_IWDG_STOP) {
    printf("IWDG_STOP enable\r\n");
    obConfig.USERConfig &= ~FLASH_OPTR_IWDG_STOP;
    wflag = 1;
  }
  if (wflag) {
    obConfig.OptionType = OPTIONBYTE_USER;
    if (HAL_FLASHEx_OBProgram(&obConfig) == HAL_OK) {
      if (HAL_FLASH_OB_Launch() != HAL_OK) HAL_NVIC_SystemReset();
    } else {
      printf("Flash OPT program failed!\r\n");
    }
  }
  // Check if RDP level is 0
  // if (obConfig.RDPLevel == OB_RDP_LEVEL_0) {
  //   printf("RDP Level is 0\r\n");
  //   obConfig.RDPLevel = OB_RDP_LEVEL_1;
  //   wflag = 1;
  // }
  // if (wflag) {
  //   obConfig.OptionType = OPTIONBYTE_RDP;
  //   if (HAL_FLASHEx_OBProgram(&obConfig) == HAL_OK) {
  //     if (HAL_FLASH_OB_Launch() != HAL_OK) HAL_NVIC_SystemReset();
  //   } else {
  //     printf("Flash OPT program failed!\r\n");
  //   }
  // }
  HAL_FLASH_OB_Lock();
  HAL_FLASH_Lock();
}
/**
 * @brief TIM6 microsecond delay initialization
 * @note System clock 56MHz, TIM6 clock 56MHz
 */
void TIM6_Delay_Init(void)
{
    // 1. Enable TIM6 clock
    __HAL_RCC_TIM6_CLK_ENABLE();
    
    // 2. Configure TIM6
    TIM6->PSC = 15;         // Prescaler = 15, counter clock = 1MHz
    TIM6->ARR = 0xFFFF;     // Auto-reload value, 16-bit maximum
    TIM6->CR1 = 0;          // Up-counting mode
    TIM6->EGR |= TIM_EGR_UG; // Generate update event, reset counter
    
    // 3. Start timer
    TIM6->CR1 |= TIM_CR1_CEN;
}
/**
 * @brief TIM6 microsecond delay function
 * @param us: Delay time in microseconds (1-65535)
 */
void delay_us(uint16_t us)
{
    uint16_t start = TIM6->CNT;
    uint16_t delay_ticks = us;
    
    // Handle counter overflow case
    if((0xFFFF - start) >= delay_ticks)
    {
        // No overflow case
        while((TIM6->CNT - start) < delay_ticks);
    }
    else
    {
        // Overflow case
        delay_ticks -= (0xFFFF - start);
        while(TIM6->CNT < delay_ticks);
    }
}
/* USER CODE END 0 */

/**
  * @brief  The application entry point.
  * @retval int
  */
int main(void)
{

  /* MCU Configuration--------------------------------------------------------*/

  /* Reset of all peripherals, Initializes the Flash interface and the Systick. */
  HAL_Init();

  /* Configure the system clock */
  SystemClock_Config();

  /* Initialize all configured peripherals */
  MX_GPIO_Init();
  MX_DMA_Init();
  // MX_CRC_Init();
  MX_LPUART2_UART_Init();
  MX_USART1_UART_Init();
  // MX_SPI3_Init();
  MX_RTC_Init();
  MX_IWDG_Init();
  /* USER CODE BEGIN 2 */
  Flash_OPT_Check();
  TIM6_Delay_Init();
  /* USER CODE END 2 */

  /* Init scheduler */
  osKernelInitialize();
  /* Call init function for freertos objects (in app_freertos.c) */
  MX_FREERTOS_Init();

  /* Start scheduler */
  osKernelStart();

  /* We should never get here as control is now taken by the scheduler */

  /* Infinite loop */
  /* USER CODE BEGIN WHILE */
  while (1)
  {
    /* USER CODE END WHILE */

    /* USER CODE BEGIN 3 */
  }
  /* USER CODE END 3 */
}

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
