FITYYDS/ne301/Custom/Hal/fx_stm32_sd_driver.h

/**************************************************************************/
/*                                                                        */
/*       Copyright (c) Microsoft Corporation. All rights reserved.        */
/*                                                                        */
/*       This software is licensed under the Microsoft Software License   */
/*       Terms for Microsoft Azure RTOS. Full text of the license can be  */
/*       found in the LICENSE file at https://aka.ms/AzureRTOS_EULA       */
/*       and in the root directory of this software.                      */
/*                                                                        */
/**************************************************************************/

/* Define to prevent recursive inclusion -------------------------------------*/
#ifndef FX_STM32_SD_DRIVER_H
#define FX_STM32_SD_DRIVER_H

#ifdef __cplusplus
extern "C" {
#endif

/* Includes ------------------------------------------------------------------*/
#include "fx_api.h"
#include "cmsis_os2.h"
#include "stm32n6xx_hal.h"

/* Exported types ------------------------------------------------------------*/
extern osSemaphoreId_t sd_sem_tx;
extern osSemaphoreId_t sd_sem_rx;
/* Exported constants --------------------------------------------------------*/
/* Default timeout used to wait for fx operations */
/* Reduced from 10s to 2s to avoid long blocking on errors */
#define FX_STM32_SD_DEFAULT_TIMEOUT                      (1 * TX_TIMER_TICKS_PER_SECOND)

/* Let the filex low-level driver initialize the SD driver */
#define FX_STM32_SD_INIT                                 1

/* Enable the cache mainatenance, required when using the SD DMA */
#define FX_STM32_SD_CACHE_MAINTENANCE                    1

#define FX_ENABLE_EXFAT                                  1
/* Use the SD DMA API */
#define FX_STM32_SD_DMA_API                              1

/* SDIO instance to be used by FileX */
#define FX_STM32_SD_INSTANCE                             0

/* Default sector size, used by the driver */
#define FX_STM32_SD_DEFAULT_SECTOR_SIZE                  512

// #define FX_ENABLE_EXFAT

/* Exported macro ------------------------------------------------------------*/
/* Define the CPU Cache maintenance macros */
#if (FX_STM32_SD_CACHE_MAINTENANCE == 1)
#define invalidate_cache_by_addr(__ptr__, __size__)                  SCB_InvalidateDCache_by_Addr((void *)__ptr__, (int32_t)__size__)
#define clean_cache_by_addr(__ptr__, __size__)                       SCB_CleanDCache_by_Addr((uint32_t *)__ptr__, (int32_t)__size__)
#endif
/* Define the macro to get the current time in ticks */
/* USER CODE BEGIN FX_STM32_SD_CURRENT_TIME_TX */

#define FX_STM32_SD_CURRENT_TIME()                                   osKernelGetTickCount()

/* USER CODE END FX_STM32_SD_CURRENT_TIME_TX */

/* Macro called before initializing the SD driver
 * e.g. create a semaphore used for transfer notification */
/* USER CODE BEGIN FX_STM32_SD_PRE_INIT */

#define FX_STM32_SD_PRE_INIT(_media_ptr)

/* USER CODE END FX_STM32_SD_PRE_INIT */

/* Macro called after initializing the SD driver */
/* USER CODE BEGIN FX_STM32_SD_POST_INIT */

#define FX_STM32_SD_POST_INIT(_media_ptr)

/* USER CODE END FX_STM32_SD_POST_INIT */

/* Macro called after the SD deinit */
/* USER CODE BEGIN FX_STM32_SD_POST_DEINIT */

#define FX_STM32_SD_POST_DEINIT(_media_ptr)

/* USER CODE END FX_STM32_SD_POST_DEINIT */

/* Macro called after the abort request */
/* USER CODE BEGIN FX_STM32_SD_POST_ABORT */

#define FX_STM32_SD_POST_ABORT(_media_ptr)

/* USER CODE END FX_STM32_SD_POST_ABORT */

/* Macro called before performing read operation */
/* USER CODE BEGIN FX_STM32_SD_PRE_READ_TRANSFER */

#define FX_STM32_SD_PRE_READ_TRANSFER(_media_ptr)

/* USER CODE END FX_STM32_SD_PRE_READ_TRANSFER */

/* Macro called after performing read operation */
/* USER CODE BEGIN FX_STM32_SD_POST_READ_TRANSFER */

#define FX_STM32_SD_POST_READ_TRANSFER(_media_ptr)

/* USER CODE END FX_STM32_SD_POST_READ_TRANSFER */

/* Macro for read error handling */
/* USER CODE BEGIN FX_STM32_SD_READ_TRANSFER_ERROR */

#define FX_STM32_SD_READ_TRANSFER_ERROR(_status_)

/* USER CODE END FX_STM32_SD_READ_TRANSFER_ERROR */

/* Define how to notify about Read completion operation */

/* USER CODE BEGIN FX_STM32_SD_READ_CPLT_NOTIFY */

#define FX_STM32_SD_READ_CPLT_NOTIFY()                 do { \
                                                          if(osSemaphoreAcquire(sd_sem_rx, FX_STM32_SD_DEFAULT_TIMEOUT) != osOK) \
                                                            { \
                                                              return FX_IO_ERROR; \
                                                            } \
                                                        } while(0)

/* USER CODE END FX_STM32_SD_READ_CPLT_NOTIFY */

/* Define how to notify about write completion operation */
/* USER CODE BEGIN FX_STM32_SD_WRITE_CPLT_NOTIFY */

#define FX_STM32_SD_WRITE_CPLT_NOTIFY()                do { \
                                                          if(osSemaphoreAcquire(sd_sem_tx, FX_STM32_SD_DEFAULT_TIMEOUT) != osOK) \
                                                            { \
                                                              return FX_IO_ERROR; \
                                                            } \
                                                        } while(0)

/* USER CODE END FX_STM32_SD_WRITE_CPLT_NOTIFY */

/* Macro called before performing write operation */
/* USER CODE BEGIN FX_STM32_SD_PRE_WRITE_TRANSFER */

#define FX_STM32_SD_PRE_WRITE_TRANSFER(_media_ptr)

/* USER CODE END FX_STM32_SD_PRE_WRITE_TRANSFER */

/* Macro called after performing write operation */
/* USER CODE BEGIN FX_STM32_SD_POST_WRITE_TRANSFER */

#define FX_STM32_SD_POST_WRITE_TRANSFER(_media_ptr)

/* USER CODE END FX_STM32_SD_POST_WRITE_TRANSFER */

/* Macro for write error handling */
/* USER CODE BEGIN FX_STM32_SD_WRITE_TRANSFER_ERROR */

#define FX_STM32_SD_WRITE_TRANSFER_ERROR(_status_)

/* USER CODE END FX_STM32_SD_WRITE_TRANSFER_ERROR */

/* Exported functions prototypes ---------------------------------------------*/

INT fx_stm32_sd_init(UINT instance);
INT fx_stm32_sd_deinit(UINT instance);

INT fx_stm32_sd_get_status(UINT instance);

INT fx_stm32_sd_read_blocks(UINT instance, UINT *buffer, UINT start_block, UINT total_blocks);
INT fx_stm32_sd_write_blocks(UINT instance, UINT *buffer, UINT start_block, UINT total_blocks);

VOID fx_stm32_sd_driver(FX_MEDIA *media_ptr);

#ifdef __cplusplus
}
#endif

#endif /* FX_STM32_SD_DRIVER_H */
