FITYYDS/ne301/Custom/Services/Web/api/api_device_module.c

/**
 * @file api_device_module.c
 * @brief Device API Module Implementation
 * @details Device management API implementation based on device_service
 */

#include "api_device_module.h"
#include "web_api.h"
#include "device_service.h"
#include "debug.h"
#include "cJSON.h"
#include "drtc.h"
#include <string.h>
#include <stdio.h>
#include <stdlib.h>
#include <time.h>
#include "buffer_mgr.h"
#include "stm32n6xx_hal_cortex.h"
#include "generic_file.h"
#include "json_config_mgr.h"
#include "json_config_internal.h"
#include "ai_service.h"
#include "ota_service.h"
#include "ota_header.h"
#include "storage.h"
#include "version.h"
#include "fsbl_app_common.h"

/* ==================== Helper Functions ==================== */

static uint32_t restart_delay_seconds = 3;
static uint8_t s_restart_task_stack[1024];
static uint32_t s_restart_delay_storage;

/**
 * @brief Restart task function
 */
static void restart_task_function(void* arg) {
    uint32_t delay = *(uint32_t*)arg;

    osDelay(delay * 1000); // Convert seconds to milliseconds
    
    printf("Executing system restart...\r\n");
    
    // Perform system restart using HAL
#if ENABLE_U0_MODULE
    u0_module_clear_wakeup_flag();
    u0_module_reset_chip_n6();
#endif
    HAL_NVIC_SystemReset();
}

/**
 * @brief Factory reset task function
 */
static void factory_reset_task_function(void* arg) {
    uint32_t delay = *(uint32_t*)arg;

    printf("Factory reset task started, delay: %lu seconds\r\n", delay);

    osDelay(delay * 1000); // Convert seconds to milliseconds
    
    printf("Executing factory reset...\r\n");
    
    // Trigger factory reset (includes LED blink, config reset, AI model clear, and system restart)
    aicam_result_t result = device_service_reset_to_factory_defaults();
    if (result != AICAM_OK) {
        LOG_SVC_ERROR("Failed to reset to factory defaults: %d", result);
        // Fallback: force restart anyway
#if ENABLE_U0_MODULE
        u0_module_clear_wakeup_flag();
        u0_module_reset_chip_n6();
#endif
        HAL_NVIC_SystemReset();
    }
}

/**
 * @brief Convert light mode to string
 */
static const char* get_light_mode_string(light_mode_t mode) {
    switch (mode) {
        case LIGHT_MODE_OFF:
            return "off";
        case LIGHT_MODE_ON:
            return "on";
        case LIGHT_MODE_AUTO:
            return "auto";
        case LIGHT_MODE_CUSTOM:
            return "custom";
        default:
            return "unknown";
    }
}

/**
 * @brief Parse light mode from string
 */
static light_mode_t parse_light_mode(const char* mode_str) {
    if (!mode_str) return LIGHT_MODE_AUTO;
    
    if (strcmp(mode_str, "off") == 0) {
        return LIGHT_MODE_OFF;
    } else if (strcmp(mode_str, "on") == 0) {
        return LIGHT_MODE_ON;
    } else if (strcmp(mode_str, "auto") == 0) {
        return LIGHT_MODE_AUTO;
    } else if (strcmp(mode_str, "custom") == 0) {
        return LIGHT_MODE_CUSTOM;
    }
    
    return LIGHT_MODE_AUTO; // Default
}

/**
 * @brief Check if device service is running
 */
static aicam_bool_t is_device_service_running(void) {
    service_state_t state = device_service_get_state();
    return (state == SERVICE_STATE_RUNNING);
}

/* ==================== API Handler Functions ==================== */

/**
 * @brief GET /api/v1/device/info - Get device information
 */
aicam_result_t device_info_handler(http_handler_context_t *ctx) {
    if (!ctx) return AICAM_ERROR_INVALID_PARAM;
    
    // Only allow GET method
    if (!web_api_verify_method(ctx, "GET")) {
        return api_response_error(ctx, API_ERROR_METHOD_NOT_ALLOWED, "Only GET method is allowed");
    }
    
    // Check if device service is running
    if (!is_device_service_running()) {
        return api_response_error(ctx, API_ERROR_SERVICE_UNAVAILABLE, "Device service is not running");
    }
    
    // Get device information
    device_info_config_t device_info;
    aicam_result_t result = device_service_get_info(&device_info);
    if (result != AICAM_OK) {
        return api_response_error(ctx, API_ERROR_INTERNAL_ERROR, "Failed to get device information");
    }
    
    // Create response JSON
    cJSON* response_json = cJSON_CreateObject();
    if (!response_json) {
        return api_response_error(ctx, API_ERROR_INTERNAL_ERROR, "Failed to create response");
    }
    
    // Add device basic information
    cJSON_AddStringToObject(response_json, "device_name", device_info.device_name);
    cJSON_AddStringToObject(response_json, "mac_address", device_info.mac_address);
    cJSON_AddStringToObject(response_json, "serial_number", device_info.serial_number);
    cJSON_AddStringToObject(response_json, "hardware_version", device_info.hardware_version);
    cJSON_AddStringToObject(response_json, "software_version", device_info.software_version);
    cJSON_AddStringToObject(response_json, "camera_module", device_info.camera_module);
    cJSON_AddStringToObject(response_json, "extension_modules", device_info.extension_modules);
    cJSON_AddStringToObject(response_json, "power_supply_type", device_info.power_supply_type);
    cJSON_AddNumberToObject(response_json, "battery_percent", device_info.battery_percent);
    cJSON_AddStringToObject(response_json, "communication_type", device_info.communication_type);
    
    // Add storage information
    cJSON_AddStringToObject(response_json, "storage_card_info", device_info.storage_card_info);
    cJSON_AddNumberToObject(response_json, "storage_usage_percent", device_info.storage_usage_percent);
    
    // Send response
    char* json_string = cJSON_Print(response_json);
    if (!json_string) {
        cJSON_Delete(response_json);
        return api_response_error(ctx, API_ERROR_INTERNAL_ERROR, "Failed to serialize response");
    }
    
    aicam_result_t api_result = api_response_success(ctx, json_string, "Device information retrieved successfully");
    
    // Cleanup
    cJSON_Delete(response_json);
    //hal_mem_free(json_string);
    
    return api_result;
}

/**
 * @brief GET /api/v1/device/storage - Get storage information
 */
aicam_result_t device_storage_handler(http_handler_context_t *ctx) {
    if (!ctx) return AICAM_ERROR_INVALID_PARAM;
    
    // Only allow GET method
    if (!web_api_verify_method(ctx, "GET")) {
        return api_response_error(ctx, API_ERROR_METHOD_NOT_ALLOWED, "Only GET method is allowed");
    }
    
    // Check if device service is running
    if (!is_device_service_running()) {
        return api_response_error(ctx, API_ERROR_SERVICE_UNAVAILABLE, "Device service is not running");
    }
    
    // Get storage information
    storage_info_t storage_info;
    aicam_result_t result = device_service_storage_get_info(&storage_info);
    if (result != AICAM_OK) {
        return api_response_error(ctx, API_ERROR_INTERNAL_ERROR, "Failed to get storage information");
    }
    
    // Create response JSON
    cJSON* response_json = cJSON_CreateObject();
    if (!response_json) {
        return api_response_error(ctx, API_ERROR_INTERNAL_ERROR, "Failed to create response");
    }
    
    // Add storage connection status
    cJSON_AddBoolToObject(response_json, "sd_card_connected", storage_info.sd_card_connected);
    
    // Add capacity information (in MB and GB)
    cJSON_AddNumberToObject(response_json, "total_capacity_mb", storage_info.total_capacity_mb);
    cJSON_AddNumberToObject(response_json, "available_capacity_mb", storage_info.available_capacity_mb);
    cJSON_AddNumberToObject(response_json, "used_capacity_mb", storage_info.used_capacity_mb);
    cJSON_AddNumberToObject(response_json, "usage_percent", storage_info.usage_percent);
    
    // Add capacity information in GB for user-friendly display
    cJSON_AddNumberToObject(response_json, "total_capacity_gb", (double)storage_info.total_capacity_mb / 1024.0);
    cJSON_AddNumberToObject(response_json, "available_capacity_gb", (double)storage_info.available_capacity_mb / 1024.0);
    cJSON_AddNumberToObject(response_json, "used_capacity_gb", (double)storage_info.used_capacity_mb / 1024.0);
    
    // Add cyclic overwrite policy
    cJSON_AddBoolToObject(response_json, "cyclic_overwrite_enabled", storage_info.cyclic_overwrite_enabled);
    cJSON_AddNumberToObject(response_json, "overwrite_threshold_percent", storage_info.overwrite_threshold_percent);
    
    // Add status summary
    const char* status_summary;
    if (storage_info.sd_card_connected) {
        if (storage_info.usage_percent > storage_info.overwrite_threshold_percent) {
            status_summary = storage_info.cyclic_overwrite_enabled ? "full_auto_overwrite" : "full_manual_cleanup";
        } else if (storage_info.usage_percent > 80.0f) {
            status_summary = "nearly_full";
        } else {
            status_summary = "normal";
        }
    } else {
        status_summary = "no_card";
    }
    cJSON_AddStringToObject(response_json, "status", status_summary);
    
    // Send response
    char* json_string = cJSON_Print(response_json);
    if (!json_string) {
        cJSON_Delete(response_json);
        return api_response_error(ctx, API_ERROR_INTERNAL_ERROR, "Failed to serialize response");
    }
    
    aicam_result_t api_result = api_response_success(ctx, json_string, "Storage information retrieved successfully");
    
    // Cleanup
    cJSON_Delete(response_json);
    //hal_mem_free(json_string);
    
    return api_result;
}

/**
 * @brief POST /api/v1/device/storage/config - Configure storage settings
 */
aicam_result_t device_storage_config_handler(http_handler_context_t *ctx) {
    if (!ctx) return AICAM_ERROR_INVALID_PARAM;
    
    // Only allow POST method
    if (!web_api_verify_method(ctx, "POST")) {
        return api_response_error(ctx, API_ERROR_METHOD_NOT_ALLOWED, "Only POST method is allowed");
    }
    
    // Check if device service is running
    if (!is_device_service_running()) {
        return api_response_error(ctx, API_ERROR_SERVICE_UNAVAILABLE, "Device service is not running");
    }
    
    // Parse JSON request body
    cJSON* request_json = web_api_parse_body(ctx);
    if (!request_json) {
        return api_response_error(ctx, API_ERROR_INVALID_REQUEST, "Invalid JSON request body");
    }
    
    // Extract cyclic overwrite enabled flag
    cJSON* enabled_item = cJSON_GetObjectItem(request_json, "cyclic_overwrite_enabled");
    aicam_bool_t cyclic_enabled = AICAM_TRUE; // Default enabled
    if (enabled_item && cJSON_IsBool(enabled_item)) {
        cyclic_enabled = cJSON_IsTrue(enabled_item) ? AICAM_TRUE : AICAM_FALSE;
    }
    
    // Extract overwrite threshold
    cJSON* threshold_item = cJSON_GetObjectItem(request_json, "overwrite_threshold_percent");
    uint32_t threshold_percent = 80; // Default 80%
    if (threshold_item && cJSON_IsNumber(threshold_item)) {
        double threshold_value = cJSON_GetNumberValue(threshold_item);
        if (threshold_value >= 50.0 && threshold_value <= 95.0) {
            threshold_percent = (uint32_t)threshold_value;
        } else {
            cJSON_Delete(request_json);
            return api_response_error(ctx, API_ERROR_INVALID_REQUEST, "Threshold must be between 50% and 95%");
        }
    }
    
    // Apply storage configuration
    aicam_result_t result = device_service_storage_set_cyclic_overwrite(cyclic_enabled, threshold_percent);
    cJSON_Delete(request_json);
    
    if (result != AICAM_OK) {
        return api_response_error(ctx, API_ERROR_INTERNAL_ERROR, "Failed to configure storage settings");
    }
    
    // Create success response
    cJSON* response_json = cJSON_CreateObject();
    if (!response_json) {
        return api_response_error(ctx, API_ERROR_INTERNAL_ERROR, "Failed to create response");
    }
    
    cJSON_AddStringToObject(response_json, "message", "Storage configuration updated successfully");
    cJSON_AddBoolToObject(response_json, "cyclic_overwrite_enabled", cyclic_enabled);
    cJSON_AddNumberToObject(response_json, "overwrite_threshold_percent", threshold_percent);
    
    // Send response
    char* json_string = cJSON_Print(response_json);
    if (!json_string) {
        cJSON_Delete(response_json);
        return api_response_error(ctx, API_ERROR_INTERNAL_ERROR, "Failed to serialize response");
    }
    
    aicam_result_t api_result = api_response_success(ctx, json_string, "Storage configuration updated successfully");
    
    // Cleanup
    cJSON_Delete(response_json);
    //hal_mem_free(json_string);
    
    return api_result;
}

/**
 * @brief GET/POST /api/v1/device/image/config - Get/Set image configuration
 */
aicam_result_t device_image_config_handler(http_handler_context_t *ctx) {
    if (!ctx) return AICAM_ERROR_INVALID_PARAM;
    
    // Check if device service is running
    if (!is_device_service_running()) {
        return api_response_error(ctx, API_ERROR_SERVICE_UNAVAILABLE, "Device service is not running");
    }
    
    if (web_api_verify_method(ctx, "GET")) {
        // GET: Return current image configuration
        camera_config_t camera_config;
        aicam_result_t result = device_service_camera_get_config(&camera_config);
        if (result != AICAM_OK) {
            return api_response_error(ctx, API_ERROR_INTERNAL_ERROR, "Failed to get image configuration");
        }
        
        // Create response JSON
        cJSON* response_json = cJSON_CreateObject();
        if (!response_json) {
            return api_response_error(ctx, API_ERROR_INTERNAL_ERROR, "Failed to create response");
        }
        
        cJSON_AddNumberToObject(response_json, "brightness", camera_config.image_config.brightness);
        cJSON_AddNumberToObject(response_json, "contrast", camera_config.image_config.contrast);
        cJSON_AddBoolToObject(response_json, "horizontal_flip", camera_config.image_config.horizontal_flip);
        cJSON_AddBoolToObject(response_json, "vertical_flip", camera_config.image_config.vertical_flip);
        cJSON_AddNumberToObject(response_json, "aec", camera_config.image_config.aec);
        cJSON_AddNumberToObject(response_json, "isp_mode", camera_config.image_config.isp_mode);
        cJSON_AddNumberToObject(response_json, "fast_capture_skip_frames", camera_config.image_config.fast_capture_skip_frames);
        cJSON_AddNumberToObject(response_json, "fast_capture_resolution", camera_config.image_config.fast_capture_resolution);
        cJSON_AddNumberToObject(response_json, "fast_capture_jpeg_quality", camera_config.image_config.fast_capture_jpeg_quality);
        cJSON_AddBoolToObject(response_json, "capture_disable_comm", camera_config.image_config.capture_disable_comm);
        cJSON_AddBoolToObject(response_json, "capture_storage_ai", camera_config.image_config.capture_storage_ai);
        
        // Send response
        char* json_string = cJSON_Print(response_json);
        if (!json_string) {
            cJSON_Delete(response_json);
            return api_response_error(ctx, API_ERROR_INTERNAL_ERROR, "Failed to serialize response");
        }
        
        aicam_result_t api_result = api_response_success(ctx, json_string, "Image configuration retrieved successfully");
        
        // Cleanup
        cJSON_Delete(response_json);
        //hal_mem_free(json_string);
        
        return api_result;
        
    } else if (web_api_verify_method(ctx, "POST")) {
        // POST: Update image configuration
        
        // Parse JSON request body
        cJSON* request_json = web_api_parse_body(ctx);
        if (!request_json) {
            return api_response_error(ctx, API_ERROR_INVALID_REQUEST, "Invalid JSON request body");
        }
        
        // Get current configuration
        image_config_t image_config;
        aicam_result_t result = device_service_image_get_config(&image_config);
        if (result != AICAM_OK) {
            cJSON_Delete(request_json);
            return api_response_error(ctx, API_ERROR_INTERNAL_ERROR, "Failed to get current image configuration");
        }

        // Keep a copy to detect whether pipeline-affecting fields changed
        image_config_t old_image_config = image_config;
        
        // Update brightness if provided
        cJSON* brightness_item = cJSON_GetObjectItem(request_json, "brightness");
        if (brightness_item && cJSON_IsNumber(brightness_item)) {
            double brightness_value = cJSON_GetNumberValue(brightness_item);
            if (brightness_value >= 0.0 && brightness_value <= 100.0) {
                image_config.brightness = (uint32_t)brightness_value;
            } else {
                cJSON_Delete(request_json);
                return api_response_error(ctx, API_ERROR_INVALID_REQUEST, "Brightness must be between 0 and 100");
            }
        }
        
        // Update contrast if provided
        cJSON* contrast_item = cJSON_GetObjectItem(request_json, "contrast");
        if (contrast_item && cJSON_IsNumber(contrast_item)) {
            double contrast_value = cJSON_GetNumberValue(contrast_item);
            if (contrast_value >= 0.0 && contrast_value <= 100.0) {
                image_config.contrast = (uint32_t)contrast_value;
            } else {
                cJSON_Delete(request_json);
                return api_response_error(ctx, API_ERROR_INVALID_REQUEST, "Contrast must be between 0 and 100");
            }
        }
        
        // Update horizontal flip if provided
        cJSON* h_flip_item = cJSON_GetObjectItem(request_json, "horizontal_flip");
        if (h_flip_item && cJSON_IsBool(h_flip_item)) {
            image_config.horizontal_flip = cJSON_IsTrue(h_flip_item) ? AICAM_TRUE : AICAM_FALSE;
        }
        
        // Update vertical flip if provided
        cJSON* v_flip_item = cJSON_GetObjectItem(request_json, "vertical_flip");
        if (v_flip_item && cJSON_IsBool(v_flip_item)) {
            image_config.vertical_flip = cJSON_IsTrue(v_flip_item) ? AICAM_TRUE : AICAM_FALSE;
        }
        

        // Update AEC if provided
        cJSON* aec_item = cJSON_GetObjectItem(request_json, "aec");
        if (aec_item && cJSON_IsNumber(aec_item)) {
            double aec_value = cJSON_GetNumberValue(aec_item);
            if (aec_value >= 0.0 && aec_value <= 100.0) {
                image_config.aec = (uint32_t)aec_value;
            }
        }

        cJSON* isp_mode_item = cJSON_GetObjectItem(request_json, "isp_mode");
        if (isp_mode_item && cJSON_IsNumber(isp_mode_item)) {
            double m = cJSON_GetNumberValue(isp_mode_item);
            if (m == (double)IMAGE_ISP_MODE_INDOOR || m == (double)IMAGE_ISP_MODE_OUTDOOR || m == (double)IMAGE_ISP_MODE_CUSTOM) {
                image_config.isp_mode = (uint32_t)m;
            } else {
                cJSON_Delete(request_json);
                return api_response_error(ctx, API_ERROR_INVALID_REQUEST, "isp_mode must be 0 (outdoor), 1 (indoor), or 255 (custom)");
            }
        }

        // Update fast capture skip frames if provided (0-300 to match CAM_CMD_SET_STARTUP_SKIP_FRAMES)
        cJSON* fast_skip_item = cJSON_GetObjectItem(request_json, "fast_capture_skip_frames");
        if (fast_skip_item && cJSON_IsNumber(fast_skip_item)) {
            double skip_value = cJSON_GetNumberValue(fast_skip_item);
            if (skip_value >= 0.0 && skip_value <= 300.0) {
                image_config.fast_capture_skip_frames = (uint32_t)skip_value;
            } else {
                cJSON_Delete(request_json);
                return api_response_error(ctx, API_ERROR_INVALID_REQUEST, "fast_capture_skip_frames must be between 0 and 300");
            }
        }

        // Update fast capture resolution if provided (0:1280x720, 1:1920x1080, 2:2688x1520)
        cJSON* fast_res_item = cJSON_GetObjectItem(request_json, "fast_capture_resolution");
        if (fast_res_item && cJSON_IsNumber(fast_res_item)) {
            double res_value = cJSON_GetNumberValue(fast_res_item);
            if (res_value >= 0.0 && res_value <= 2.0) {
                image_config.fast_capture_resolution = (uint32_t)res_value;
            }
        }

        // Update fast capture JPEG quality if provided
        cJSON* fast_jq_item = cJSON_GetObjectItem(request_json, "fast_capture_jpeg_quality");
        if (fast_jq_item && cJSON_IsNumber(fast_jq_item)) {
            double jq_value = cJSON_GetNumberValue(fast_jq_item);
            if (jq_value >= 1 && jq_value <= 100.0) {
                image_config.fast_capture_jpeg_quality = (uint32_t)jq_value;
            }
        }

        cJSON* cap_dis_comm_item = cJSON_GetObjectItem(request_json, "capture_disable_comm");
        if (cap_dis_comm_item && cJSON_IsBool(cap_dis_comm_item)) {
            image_config.capture_disable_comm = cJSON_IsTrue(cap_dis_comm_item) ? AICAM_TRUE : AICAM_FALSE;
        }

        cJSON* cap_stor_ai_item = cJSON_GetObjectItem(request_json, "capture_storage_ai");
        if (cap_stor_ai_item && cJSON_IsBool(cap_stor_ai_item)) {
            image_config.capture_storage_ai = cJSON_IsTrue(cap_stor_ai_item) ? AICAM_TRUE : AICAM_FALSE;
        }

        cJSON_Delete(request_json);

        // Determine whether changes require restarting AI pipeline
        aicam_bool_t need_restart_pipeline = AICAM_FALSE;
        if (old_image_config.brightness != image_config.brightness ||
            old_image_config.contrast != image_config.contrast ||
            old_image_config.horizontal_flip != image_config.horizontal_flip ||
            old_image_config.vertical_flip != image_config.vertical_flip ||
            old_image_config.aec != image_config.aec ||
            old_image_config.isp_mode != image_config.isp_mode) {
            need_restart_pipeline = AICAM_TRUE;
        }

        if (need_restart_pipeline) {
            // Stop pipeline before applying camera-related changes
            ai_pipeline_stop();
        }

        // Apply the updated configuration (always updates config + persistence)
        result = device_service_image_set_config(&image_config);

        if (need_restart_pipeline) {
            // Restart pipeline only when necessary
            ai_pipeline_start();
        }
        
        // Create success response
        cJSON* response_json = cJSON_CreateObject();
        if (!response_json) {
            return api_response_error(ctx, API_ERROR_INTERNAL_ERROR, "Failed to create response");
        }
        
        cJSON_AddStringToObject(response_json, "message", "Image configuration updated successfully");
        cJSON_AddNumberToObject(response_json, "brightness", image_config.brightness);
        cJSON_AddNumberToObject(response_json, "contrast", image_config.contrast);
        cJSON_AddBoolToObject(response_json, "horizontal_flip", image_config.horizontal_flip);
        cJSON_AddBoolToObject(response_json, "vertical_flip", image_config.vertical_flip);
        cJSON_AddNumberToObject(response_json, "aec", image_config.aec);
        cJSON_AddNumberToObject(response_json, "isp_mode", image_config.isp_mode);
        cJSON_AddNumberToObject(response_json, "fast_capture_skip_frames", image_config.fast_capture_skip_frames);
        cJSON_AddNumberToObject(response_json, "fast_capture_resolution", image_config.fast_capture_resolution);
        cJSON_AddNumberToObject(response_json, "fast_capture_jpeg_quality", image_config.fast_capture_jpeg_quality);
        cJSON_AddBoolToObject(response_json, "capture_disable_comm", image_config.capture_disable_comm);
        cJSON_AddBoolToObject(response_json, "capture_storage_ai", image_config.capture_storage_ai);
        
        // Send response
        char* json_string = cJSON_Print(response_json);
        if (!json_string) {
            cJSON_Delete(response_json);
            return api_response_error(ctx, API_ERROR_INTERNAL_ERROR, "Failed to serialize response");
        }
        
        aicam_result_t api_result = api_response_success(ctx, json_string, "Image configuration updated successfully");
        
        // Cleanup
        cJSON_Delete(response_json);
        //hal_mem_free(json_string);
        
        return api_result;
        
    } else {
        return api_response_error(ctx, API_ERROR_METHOD_NOT_ALLOWED, "Only GET and POST methods are allowed");
    }
}

/**
 * @brief GET/POST /api/v1/device/sys-clk/config - Read/write FSBL persisted CPU clock profile (takes effect after reboot)
 */
aicam_result_t device_sys_clk_config_handler(http_handler_context_t *ctx) {
    if (!ctx) return AICAM_ERROR_INVALID_PARAM;

    if (!is_device_service_running()) {
        return api_response_error(ctx, API_ERROR_SERVICE_UNAVAILABLE, "Device service is not running");
    }

    if (web_api_verify_method(ctx, "GET")) {
        sys_clk_config_t cfg = {0};
        int ret = fsbl_app_read_sys_clk_config(&cfg);

        cJSON* response_json = cJSON_CreateObject();
        if (!response_json) {
            return api_response_error(ctx, API_ERROR_INTERNAL_ERROR, "Failed to create response");
        }

        cJSON_AddBoolToObject(response_json, "valid", ret == 0);
        if (ret == 0) {
            cJSON_AddNumberToObject(response_json, "sys_clk_profile", (double)cfg.sys_clk_profile);
        } else {
            cJSON_AddNumberToObject(response_json, "sys_clk_profile", 0.0);
        }

        char* json_string = cJSON_Print(response_json);
        cJSON_Delete(response_json);
        if (!json_string) {
            return api_response_error(ctx, API_ERROR_INTERNAL_ERROR, "Failed to serialize response");
        }

        return api_response_success(ctx, json_string, "Sys clock configuration retrieved successfully");
    }

    if (web_api_verify_method(ctx, "POST")) {
        cJSON* request_json = web_api_parse_body(ctx);
        if (!request_json) {
            return api_response_error(ctx, API_ERROR_INVALID_REQUEST, "Invalid JSON request body");
        }

        cJSON* prof_item = cJSON_GetObjectItem(request_json, "sys_clk_profile");
        if (!prof_item || !cJSON_IsNumber(prof_item)) {
            cJSON_Delete(request_json);
            return api_response_error(ctx, API_ERROR_INVALID_REQUEST, "sys_clk_profile is required (number)");
        }

        uint32_t profile = (uint32_t)cJSON_GetNumberValue(prof_item);
        if (profile != FSBL_APP_SYSCLK_PROFILE_HSE_200MHZ &&
            profile != FSBL_APP_SYSCLK_PROFILE_HSE_400MHZ &&
            profile != FSBL_APP_SYSCLK_PROFILE_HSI_800MHZ &&
            profile != FSBL_APP_SYSCLK_PROFILE_HSE_800MHZ) {
            cJSON_Delete(request_json);
            return api_response_error(ctx, API_ERROR_INVALID_REQUEST,
                                      "sys_clk_profile must be 1 (HSE 200), 2 (HSE 400), 3 (HSI 800), or 4 (HSE 800)");
        }

        sys_clk_config_t cfg = {0};
        cfg.sys_clk_profile = profile;
        int wret = fsbl_app_write_sys_clk_config(&cfg);
        cJSON_Delete(request_json);

        if (wret != 0) {
            return api_response_error(ctx, API_ERROR_INTERNAL_ERROR, "Failed to write sys clock configuration");
        }

        cJSON* response_json = cJSON_CreateObject();
        if (!response_json) {
            return api_response_error(ctx, API_ERROR_INTERNAL_ERROR, "Failed to create response");
        }

        cJSON_AddStringToObject(response_json, "message",
                                "Sys clock profile saved; reboot the device for FSBL to apply the new frequency");
        cJSON_AddNumberToObject(response_json, "sys_clk_profile", (double)profile);

        char* json_string = cJSON_Print(response_json);
        cJSON_Delete(response_json);
        if (!json_string) {
            return api_response_error(ctx, API_ERROR_INTERNAL_ERROR, "Failed to serialize response");
        }

        return api_response_success(ctx, json_string, "Sys clock configuration updated successfully");
    }

    return api_response_error(ctx, API_ERROR_METHOD_NOT_ALLOWED, "Only GET and POST methods are allowed");
}

/**
 * @brief GET/POST /api/v1/device/light/config - Get/Set light configuration
 */
aicam_result_t device_light_config_handler(http_handler_context_t *ctx) {
    if (!ctx) return AICAM_ERROR_INVALID_PARAM;
    
    // Check if device service is running
    if (!is_device_service_running()) {
        return api_response_error(ctx, API_ERROR_SERVICE_UNAVAILABLE, "Device service is not running");
    }
    
    if (web_api_verify_method(ctx, "GET")) {
        // GET: Return current light configuration
        light_config_t light_config;
        aicam_result_t result = device_service_light_get_config(&light_config);
        if (result != AICAM_OK) {
            return api_response_error(ctx, API_ERROR_INTERNAL_ERROR, "Failed to get light configuration");
        }
        
        // Create response JSON
        cJSON* response_json = cJSON_CreateObject();
        if (!response_json) {
            return api_response_error(ctx, API_ERROR_INTERNAL_ERROR, "Failed to create response");
        }
        
        cJSON_AddBoolToObject(response_json, "connected", light_config.connected);
        cJSON_AddStringToObject(response_json, "mode", get_light_mode_string(light_config.mode));
        cJSON_AddNumberToObject(response_json, "brightness_level", light_config.brightness_level);
        //cJSON_AddBoolToObject(response_json, "auto_trigger_enabled", light_config.auto_trigger_enabled);
        //cJSON_AddNumberToObject(response_json, "light_threshold", light_config.light_threshold);
        
        // Add custom schedule information
        cJSON* schedule_json = cJSON_CreateObject();
        if (schedule_json) {
            cJSON_AddNumberToObject(schedule_json, "start_hour", light_config.start_hour);
            cJSON_AddNumberToObject(schedule_json, "start_minute", light_config.start_minute);
            cJSON_AddNumberToObject(schedule_json, "end_hour", light_config.end_hour);
            cJSON_AddNumberToObject(schedule_json, "end_minute", light_config.end_minute);
            cJSON_AddItemToObject(response_json, "custom_schedule", schedule_json);
        }
        
        // Send response
        char* json_string = cJSON_Print(response_json);
        if (!json_string) {
            cJSON_Delete(response_json);
            return api_response_error(ctx, API_ERROR_INTERNAL_ERROR, "Failed to serialize response");
        }
        
        aicam_result_t api_result = api_response_success(ctx, json_string, "Light configuration retrieved successfully");
        
        // Cleanup
        cJSON_Delete(response_json);
        //hal_mem_free(json_string);
        
        return api_result;
        
    } else if (web_api_verify_method(ctx, "POST")) {
        // POST: Update light configuration
        
        // Parse JSON request body
        cJSON* request_json = web_api_parse_body(ctx);
        if (!request_json) {
            return api_response_error(ctx, API_ERROR_INVALID_REQUEST, "Invalid JSON request body");
        }
        
        // Get current configuration
        light_config_t light_config;
        aicam_result_t result = device_service_light_get_config(&light_config);
        if (result != AICAM_OK) {
            cJSON_Delete(request_json);
            return api_response_error(ctx, API_ERROR_INTERNAL_ERROR, "Failed to get current light configuration");
        }
        
        // Update mode if provided
        cJSON* mode_item = cJSON_GetObjectItem(request_json, "mode");
        if (mode_item && cJSON_IsString(mode_item)) {
            light_config.mode = parse_light_mode(cJSON_GetStringValue(mode_item));
        }
        
        // Update brightness level if provided
        cJSON* brightness_item = cJSON_GetObjectItem(request_json, "brightness_level");
        if (brightness_item && cJSON_IsNumber(brightness_item)) {
            double brightness_value = cJSON_GetNumberValue(brightness_item);
            if (brightness_value >= 0.0 && brightness_value <= 100.0) {
                light_config.brightness_level = (uint32_t)brightness_value;
            } else {
                cJSON_Delete(request_json);
                return api_response_error(ctx, API_ERROR_INVALID_REQUEST, "Brightness level must be between 0 and 100");
            }
        }
        
        // Update auto trigger if provided
        // cJSON* auto_trigger_item = cJSON_GetObjectItem(request_json, "auto_trigger_enabled");
        // if (auto_trigger_item && cJSON_IsBool(auto_trigger_item)) {
        //     light_config.auto_trigger_enabled = cJSON_IsTrue(auto_trigger_item) ? AICAM_TRUE : AICAM_FALSE;
        // }
        
        // Update light threshold if provided
        // cJSON* threshold_item = cJSON_GetObjectItem(request_json, "light_threshold");
        // if (threshold_item && cJSON_IsNumber(threshold_item)) {
        //     double threshold_value = cJSON_GetNumberValue(threshold_item);
        //     if (threshold_value >= 0.0 && threshold_value <= 1000.0) {
        //         light_config.light_threshold = (uint32_t)threshold_value;
        //     } else {
        //         cJSON_Delete(request_json);
        //         return api_response_error(ctx, API_ERROR_INVALID_REQUEST, "Light threshold must be between 0 and 1000");
        //     }
        // }
        
        // Update custom schedule if provided
        cJSON* schedule_item = cJSON_GetObjectItem(request_json, "custom_schedule");
        if (schedule_item && cJSON_IsObject(schedule_item)) {
            cJSON* start_hour_item = cJSON_GetObjectItem(schedule_item, "start_hour");
            if (start_hour_item && cJSON_IsNumber(start_hour_item)) {
                double hour_value = cJSON_GetNumberValue(start_hour_item);
                if (hour_value >= 0.0 && hour_value <= 23.0) {
                    light_config.start_hour = (uint32_t)hour_value;
                }
            }
            
            cJSON* start_minute_item = cJSON_GetObjectItem(schedule_item, "start_minute");
            if (start_minute_item && cJSON_IsNumber(start_minute_item)) {
                double minute_value = cJSON_GetNumberValue(start_minute_item);
                if (minute_value >= 0.0 && minute_value <= 59.0) {
                    light_config.start_minute = (uint32_t)minute_value;
                }
            }
            
            cJSON* end_hour_item = cJSON_GetObjectItem(schedule_item, "end_hour");
            if (end_hour_item && cJSON_IsNumber(end_hour_item)) {
                double hour_value = cJSON_GetNumberValue(end_hour_item);
                if (hour_value >= 0.0 && hour_value <= 23.0) {
                    light_config.end_hour = (uint32_t)hour_value;
                }
            }
            
            cJSON* end_minute_item = cJSON_GetObjectItem(schedule_item, "end_minute");
            if (end_minute_item && cJSON_IsNumber(end_minute_item)) {
                double minute_value = cJSON_GetNumberValue(end_minute_item);
                if (minute_value >= 0.0 && minute_value <= 59.0) {
                    light_config.end_minute = (uint32_t)minute_value;
                }
            }
        }
        
        cJSON_Delete(request_json);
        
        // Apply the updated configuration
        result = device_service_light_set_config(&light_config);
        if (result != AICAM_OK) {
            return api_response_error(ctx, API_ERROR_INTERNAL_ERROR, "Failed to set light configuration");
        }
        
        // Create success response with updated configuration
        cJSON* response_json = cJSON_CreateObject();
        if (!response_json) {
            return api_response_error(ctx, API_ERROR_INTERNAL_ERROR, "Failed to create response");
        }
        
        cJSON_AddStringToObject(response_json, "message", "Light configuration updated successfully");
        cJSON_AddStringToObject(response_json, "mode", get_light_mode_string(light_config.mode));
        cJSON_AddNumberToObject(response_json, "brightness_level", light_config.brightness_level);
        //cJSON_AddBoolToObject(response_json, "auto_trigger_enabled", light_config.auto_trigger_enabled);
        //cJSON_AddNumberToObject(response_json, "light_threshold", light_config.light_threshold);
        
        // Send response
        char* json_string = cJSON_Print(response_json);
        if (!json_string) {
            cJSON_Delete(response_json);
            return api_response_error(ctx, API_ERROR_INTERNAL_ERROR, "Failed to serialize response");
        }
        
        aicam_result_t api_result = api_response_success(ctx, json_string, "Light configuration updated successfully");
        
        // Cleanup
        cJSON_Delete(response_json);
        //hal_mem_free(json_string);
        
        return api_result;
        
    } else {
        return api_response_error(ctx, API_ERROR_METHOD_NOT_ALLOWED, "Only GET and POST methods are allowed");
    }
}

/**
 * @brief POST /api/v1/device/light/control - Manual light control
 */
aicam_result_t device_light_control_handler(http_handler_context_t *ctx) {
    if (!ctx) return AICAM_ERROR_INVALID_PARAM;
    
    // Only allow POST method
    if (!web_api_verify_method(ctx, "POST")) {
        return api_response_error(ctx, API_ERROR_METHOD_NOT_ALLOWED, "Only POST method is allowed");
    }
    
    // Check if device service is running
    if (!is_device_service_running()) {
        return api_response_error(ctx, API_ERROR_SERVICE_UNAVAILABLE, "Device service is not running");
    }
    
    // Check if light is connected
    if (!device_service_light_is_connected()) {
        return api_response_error(ctx, API_ERROR_NOT_FOUND, "Light device is not connected");
    }
    
    // Parse JSON request body
    cJSON* request_json = web_api_parse_body(ctx);
    if (!request_json) {
        return api_response_error(ctx, API_ERROR_INVALID_REQUEST, "Invalid JSON request body");
    }
    
    // Extract enable flag
    cJSON* enable_item = cJSON_GetObjectItem(request_json, "enable");
    if (!enable_item || !cJSON_IsBool(enable_item)) {
        cJSON_Delete(request_json);
        return api_response_error(ctx, API_ERROR_INVALID_REQUEST, "Missing or invalid 'enable' field");
    }
    
    aicam_bool_t enable = cJSON_IsTrue(enable_item) ? AICAM_TRUE : AICAM_FALSE;
    cJSON_Delete(request_json);
    
    // Control the light
    aicam_result_t result = device_service_light_control(enable);
    if (result != AICAM_OK) {
        return api_response_error(ctx, API_ERROR_INTERNAL_ERROR, "Failed to control light");
    }
    
    // Create success response
    cJSON* response_json = cJSON_CreateObject();
    if (!response_json) {
        return api_response_error(ctx, API_ERROR_INTERNAL_ERROR, "Failed to create response");
    }
    
    cJSON_AddStringToObject(response_json, "message", enable ? "Light turned on" : "Light turned off");
    cJSON_AddBoolToObject(response_json, "enabled", enable);
    
    // Send response
    char* json_string = cJSON_Print(response_json);
    if (!json_string) {
        cJSON_Delete(response_json);
        return api_response_error(ctx, API_ERROR_INTERNAL_ERROR, "Failed to serialize response");
    }
    
    aicam_result_t api_result = api_response_success(ctx, json_string, "Light control executed successfully");
    
    // Cleanup
    cJSON_Delete(response_json);
    //hal_mem_free(json_string);
    
    return api_result;
}
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
