FITYYDS/ne301/FSBL/Core/Src/xspim.c

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
/* Includes ------------------------------------------------------------------*/
#include "xspim.h"
#include <stdio.h>

XSPI_HandleTypeDef hxspi1;
XSPI_HandleTypeDef hxspi2;
static void XSPI_NOR_OctalDTRModeCfg(XSPI_HandleTypeDef *hxspi);
uint32_t APS256_WriteReg(XSPI_HandleTypeDef *Ctx, uint32_t Address, uint8_t *Value);
uint32_t APS256_ReadReg(XSPI_HandleTypeDef *Ctx, uint32_t Address, uint8_t *Value, uint32_t LatencyCode);

/* XSPIM init function */
void MX_XSPIM_Init(void)
{


}

/**
  * @brief XSPI2 Initialization Function
  * @param None
  * @retval None
  */
void MX_XSPI2_Init(void)
{

    XSPIM_CfgTypeDef sXspiManagerCfg = {0};

    /* XSPI2 parameter configuration*/
    hxspi2.Instance = XSPI2;
    hxspi2.Init.FifoThresholdByte = 4;
    hxspi2.Init.MemoryMode = HAL_XSPI_SINGLE_MEM;
    hxspi2.Init.MemoryType = HAL_XSPI_MEMTYPE_MACRONIX;
    hxspi2.Init.MemorySize = HAL_XSPI_SIZE_1GB;
    hxspi2.Init.ChipSelectHighTimeCycle = 1;
    hxspi2.Init.FreeRunningClock = HAL_XSPI_FREERUNCLK_DISABLE;
    hxspi2.Init.ClockMode = HAL_XSPI_CLOCK_MODE_0;
    hxspi2.Init.WrapSize = HAL_XSPI_WRAP_NOT_SUPPORTED;
    hxspi2.Init.ClockPrescaler = 1;
    hxspi2.Init.SampleShifting = HAL_XSPI_SAMPLE_SHIFT_NONE;
    hxspi2.Init.DelayHoldQuarterCycle = HAL_XSPI_DHQC_ENABLE;
    hxspi2.Init.ChipSelectBoundary = HAL_XSPI_BONDARYOF_NONE;
    hxspi2.Init.MaxTran = 0;
    hxspi2.Init.Refresh = 0;
    hxspi2.Init.MemorySelect = HAL_XSPI_CSSEL_NCS1;
    if (HAL_XSPI_Init(&hxspi2) != HAL_OK)
    {
        Error_Handler();
    }
    sXspiManagerCfg.nCSOverride = HAL_XSPI_CSSEL_OVR_NCS1;
    sXspiManagerCfg.IOPort = HAL_XSPIM_IOPORT_2;
    sXspiManagerCfg.Req2AckTime = 1;
    if (HAL_XSPIM_Config(&hxspi2, &sXspiManagerCfg, HAL_XSPI_TIMEOUT_DEFAULT_VALUE) != HAL_OK)
    {
        Error_Handler();
    }
    /* USER CODE BEGIN XSPI2_Init 2 */

    XSPI_NOR_OctalDTRModeCfg(&hxspi2);

}


void MX_XSPI1_Init(void)
{

    XSPIM_CfgTypeDef sXspiManagerCfg = {0};

    /* XSPI1 parameter configuration*/
    hxspi1.Instance = XSPI1;
    hxspi1.Init.FifoThresholdByte = 4;
    hxspi1.Init.MemoryMode = HAL_XSPI_SINGLE_MEM;
    hxspi1.Init.MemoryType = HAL_XSPI_MEMTYPE_APMEM_16BITS;
#if defined(BOARD_PSRAM_SIZE) && BOARD_PSRAM_SIZE == 64
    /* 512 Mbits = 64 MBytes PSRAM */
    hxspi1.Init.MemorySize = HAL_XSPI_SIZE_512MB;
#else
    /* 256 Mbits = 32 MBytes PSRAM */
    hxspi1.Init.MemorySize = HAL_XSPI_SIZE_256MB;
#endif
    hxspi1.Init.ChipSelectHighTimeCycle = 5;
    hxspi1.Init.FreeRunningClock = HAL_XSPI_FREERUNCLK_DISABLE;
    hxspi1.Init.ClockMode = HAL_XSPI_CLOCK_MODE_0;
    hxspi1.Init.WrapSize = HAL_XSPI_WRAP_NOT_SUPPORTED;
    hxspi1.Init.ClockPrescaler = 1;
    hxspi1.Init.SampleShifting = HAL_XSPI_SAMPLE_SHIFT_NONE;
    hxspi1.Init.DelayHoldQuarterCycle = HAL_XSPI_DHQC_DISABLE;
    hxspi1.Init.ChipSelectBoundary = HAL_XSPI_BONDARYOF_16KB;
    hxspi1.Init.MaxTran = 0;
    hxspi1.Init.Refresh = 0;
    hxspi1.Init.MemorySelect = HAL_XSPI_CSSEL_NCS1;
    if (HAL_XSPI_Init(&hxspi1) != HAL_OK)
    {
        Error_Handler();
    }
    sXspiManagerCfg.nCSOverride = HAL_XSPI_CSSEL_OVR_NCS1;
    sXspiManagerCfg.IOPort = HAL_XSPIM_IOPORT_1;
    sXspiManagerCfg.Req2AckTime = 1;
    if (HAL_XSPIM_Config(&hxspi1, &sXspiManagerCfg, HAL_XSPI_TIMEOUT_DEFAULT_VALUE) != HAL_OK)
    {
        Error_Handler();
    }
}
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
