FITYYDS/ne301/(commit log)

2026-01-15 1. feat：Integrated wifi/cat1/PoE/RS485 configuration 2. feat：rtmp and video stream optimization 3. docs：Publish the schematic diagram, PCB and 3D files 4. Fix： some bugs
    [x3_d_cover.stp, x3_m_cover.stp, x3_top_cover.stp]
2026-03-25 feat: refactor camera ISP, expand sensors, and update web hardware management
    Body:
    Update camera middleware sensor drivers and corresponding ISP parameter configurations
    Refine ISP core logic and AE/AWB-related modules
    Add/update low-level peripheral support (I2C/SPI/I2S, DMA/GPIO/interrupt handling)
    Remove obsolete audio/USB/UVC/UVCL implementation files to match the new platform needs
    Synchronize Web hardware management and cellular/network configuration UI + API changes
2026-04-01 feat(network): 4G cellular data roaming toggle
    Add end-to-end support for enabling/disabling modem data roaming from the web UI, with NVS-backed settings on the device and API feedback.
    - communication_service: load enable_roaming from stored network config at init
    - api_network_module: echo enable_roaming in cellular settings POST response JSON
    - cellular-network: Switch bound to saveCellularData.enable_roaming; en/zh strings
    - systemSettings: POST cellular config to /api/v1/system/network/cellular/settings
    - Bump web version to 1.3.4.6 (package.json, version.mk)
2026-04-03 Fix: PIR triggers capture with too long lead time issue.
    [device_service.c]
